drmus0715/trinitybullet/README.md

# プロジェクトEscape「Trinity Bullet」

「TrinityBullet」は、千葉大祭2019で披露された体験型アトラクションです。

詳しい説明は[本リポジトリのWiki](https://github.com/drmus0715/trinitybullet/wiki)を御覧ください。

### Contact

プロジェクトEscape - [pjtescape@gmail.com](mailto:pjtescape@gmail.com)  
Twitter: https://twitter.com/pjtescape  
Youtube: https://www.youtube.com/channel/UCUZIIseGtYRA30toblo56Hg
