drmus0715/trinitybullet/doc/2019 Escプロジェクト「Trinity Bullet」ソフトウェアマニュアル.pdf

# 2019 Project Escape「Trinity Bullet」

# ソフトウェアマニュアル

### 2019/10/29初版 byひろたけ

# 1. 概要

# 「Trinity Bullet」は、主に以下の4つのモジュールで構成されています。

### 1. Panel 2. Master(ESP32) 3. Game Management 4. WebServer

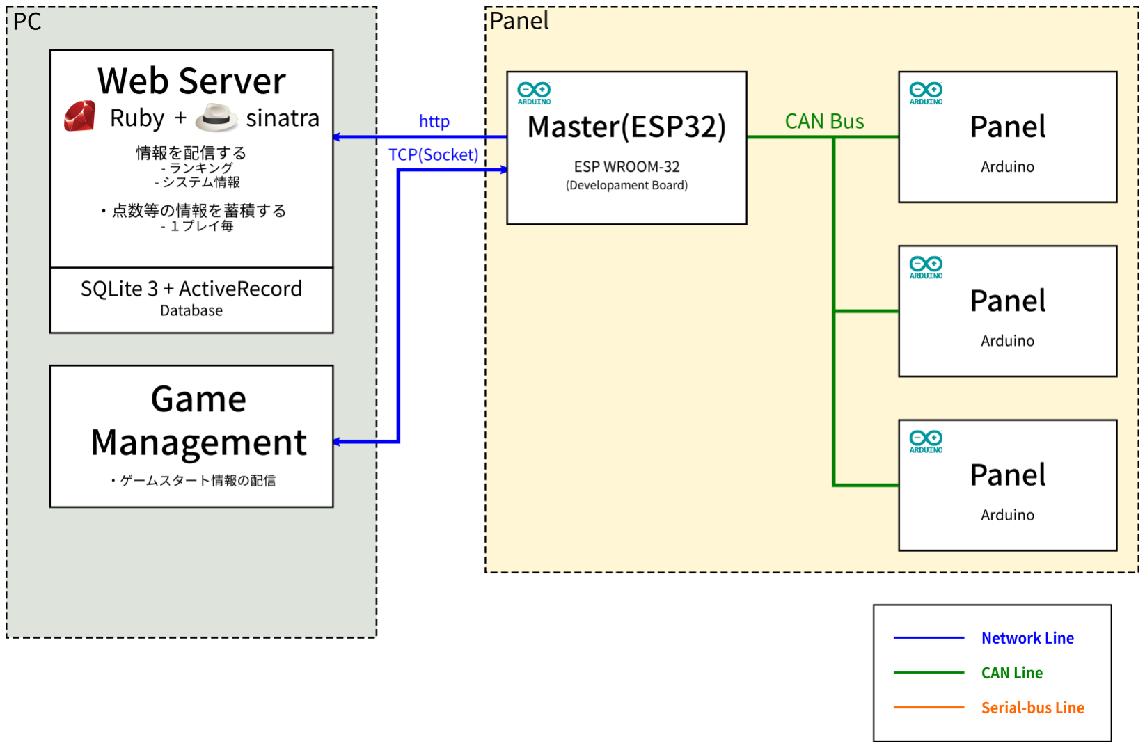
[picture p5: figure]

# また、接続系統は以下の通りです。

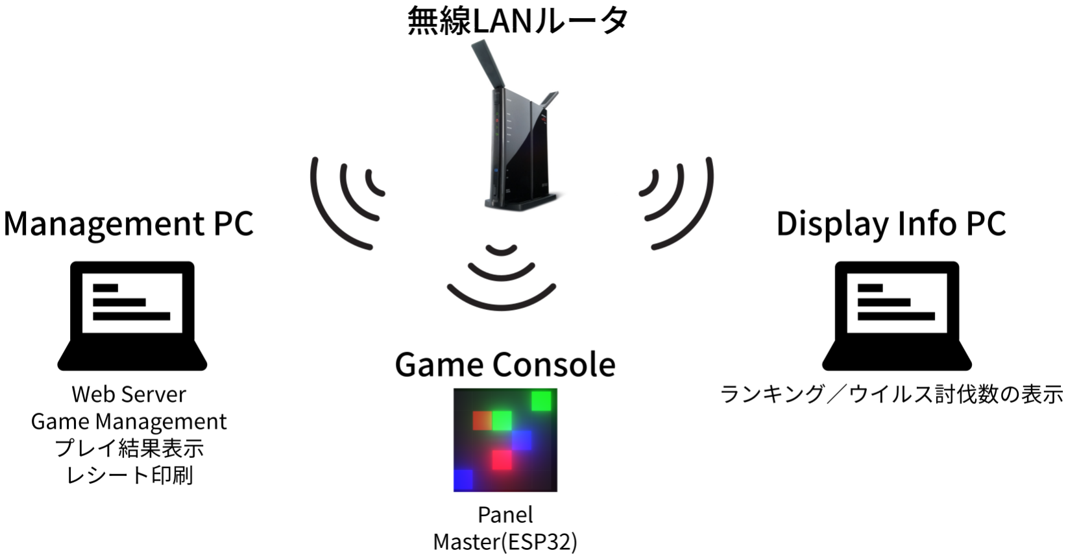
[picture p6: figure]

# 2. 起動⼿順

# ⼤まかに分けて以下の⼿順で起動します。

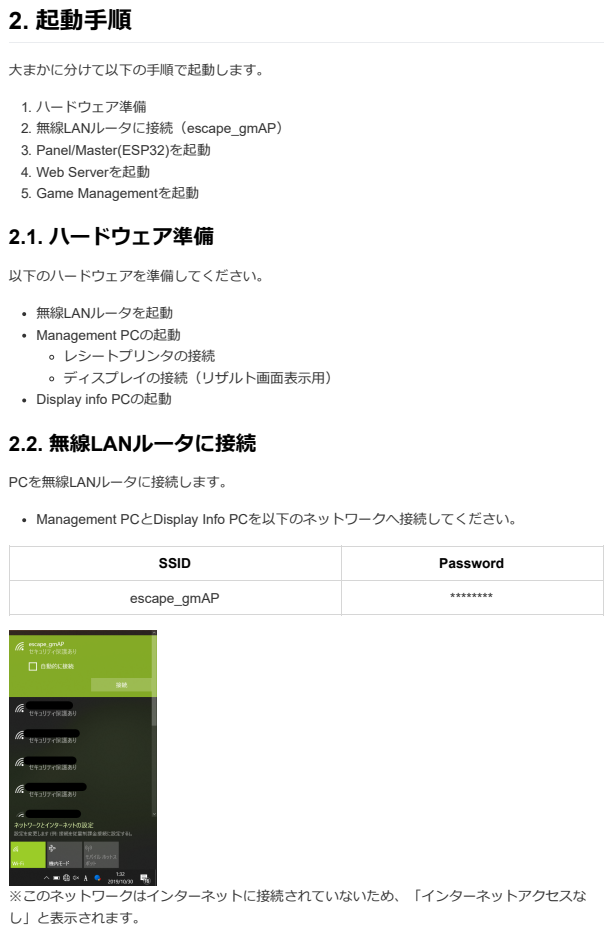
[picture p7: page 3]
PCを無線LANルータに接続します。; ※このネットワークはインターネットに接続されていないため、「インターネットアクセスな し」と表⽰されます。

1. ハードウェア準備
2. 無線LANルータに接続（escape_gmAP）
3. Panel/Master(ESP32)を起動
4. Web Serverを起動
5. Game Managementを起動
2.1. ハードウェア準備

以下のハードウェアを準備してください。
無線LANルータを起動
Management PCの起動
レシートプリンタの接続
ディスプレイの接続（リザルト画⾯表⽰⽤）
Display info PCの起動
2.2. 無線LANルータに接続

Management PCとDisplay Info PCを以下のネットワークへ接続してください。

SSID | Password

escape_gmAP | ********

# 2.3. Panel/Master(ESP32)を起動

# 基板担当に頼むと起動してくれます。

# 2.4. Web Serverを起動

### Web Serverは、Windows PowerShellを⽤いて起動・停⽌操作を⾏います。

# 1. まず、 Windowsキー＋S で検索画⾯を開き、 powershell と打ち込みます。 Enterキー を押して 起動します。

# 2. Web Serverのフォルダに移動します。以下のコマンドをシェル上に打ち込みます。 ※コマンドを打ち込んだら Enterキー で実⾏

cd C:\Users\drmus\Documents\Git\esc-magicbullet\Software\WebServer\docker-sinatra

# 以下のような表⽰になります。

PS C:\Users\drmus> cd C:\Users\drmus\Documents\Git\esc-magicbullet\Software\WebServer\docker-sinatra PS C:\Users\drmus\Documents\Git\esc-magicbullet\Software\WebServer\docker-sinatra>

# 3. docker ps コマンドを実⾏し、WebServerが起動していないことを確認します。

# ※以下のような表⽰のときは既にWebServerが起動しています。⽌める場合

は docker stop [CONTAINER ID] を実⾏します。

PS C:\Users\drmus\Documents\Git\esc-magicbullet\Software\WebServer\docker-sinatra> docker ps
CONTAINER ID | IMAGE | COMMAND | CREATED | STATUS | PORTS
PS C:\Users\drmus\Documents\Git\esc-magicbullet\Software\WebServer\docker-sinatra>

### 4. WebServerを起動します。

# 以下のコマンドを実⾏して、WebServerを起動します。

docker run -p 4567:4567 docker-sinatra

# 以下のような表⽰になったら起動成功です。

# ※以下のような表⽰になっていた場合、既にWebserverが起動しています。

### 5. Web Server終了⽅法

# WebServerが起動している状態から Ctrl+C を押下することで操作できるようになります。 以下のコマンドでWebServerをストップします。

docker stop $(docker ps -q)

## 2.4.1. 例外

# DBをリセットするとき DBをコピー→起動しているやつをストップ→コンテナを削除→再ビルド このあとは⼿順4.に移動します。

docker cp [CONTAINER ID]:/app/db/main.db ../db_backup/[NEW DB NAME].db docker stop $(docker ps -q)
docker container prune
docker build -t docker-sinatra .

# 2.5. Game Managementを起動

### PythonコンソールからGame Managementを起動します。

# 1. デスクトップ上の以下のアイコンをクリックし、Pythonコンソールを起動します。

PS C:\Users\drmus\Documents\Git\esc-magicbullet\Software\WebServer\docker-sinatra> docker ps
CONTAINER ID | IMAGE | COMMAND | CREATED | STATUS | PO
c517610d1da0 | docker-sinatra | "bundle exec ruby ap…" | 34 seconds ago | Up 32 seconds | 0.0
PS C:\Users\drmus\Documents\Git\esc-magicbullet\Software\WebServer\docker-sinatra> docker stop c517610d1da0 c517610d1da0
PS C:\Users\drmus\Documents\Git\esc-magicbullet\Software\WebServer\docker-sinatra>

PS C:\Users\drmus\Documents\Git\esc-magicbullet\Software\WebServer\docker-sinatra> docker run -p 4567:4567 d == Sinatra (v1.4.8) has taken the stage on 4567 for development with backup from Thin

PS C:\Users\drmus\Documents\Git\esc-magicbullet\Software\WebServer\docker-sinatra> docker run -p 4567:4567 d C:\Program Files\Docker\Docker\Resources\bin\docker.exe: Error response from daemon: driver failed programm PS C:\Users\drmus\Documents\Git\esc-magicbullet\Software\WebServer\docker-sinatra>

# 2. Game Managementのフォルダに移動します。以下のコマンドをシェル上に打ち込みます。 ※コマンドを打ち込んだら Enterキー で実⾏

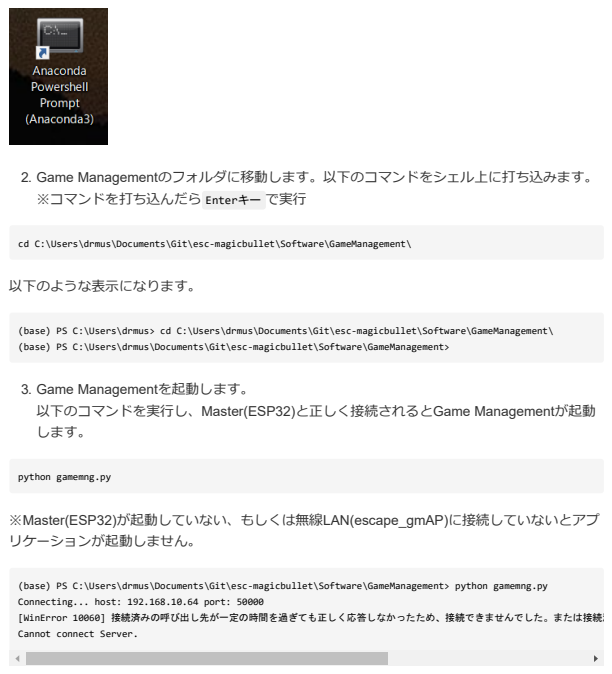
[picture p8: page 6]
以下のような表⽰になります。

cd C:\Users\drmus\Documents\Git\esc-magicbullet\Software\GameManagement\

(base) PS C:\Users\drmus> cd C:\Users\drmus\Documents\Git\esc-magicbullet\Software\GameManagement\
(base) PS C:\Users\drmus\Documents\Git\esc-magicbullet\Software\GameManagement>

3. Game Managementを起動します。
以下のコマンドを実⾏し、Master(ESP32)と正しく接続されるとGame Managementが起動
します。

python gamemng.py

※Master(ESP32)が起動していない、もしくは無線LAN(escape_gmAP)に接続していないとアプ
リケーションが起動しません。

(base) PS C:\Users\drmus\Documents\Git\esc-magicbullet\Software\GameManagement> python gamemng.py
Connecting... host: 192.168.10.64 port: 50000
[WinError 10060] 接続済みの呼び出し先が一定の時間を過ぎても正しく応答しなかったため、接続できませんでした。または接続済
Cannot connect Server.

# 3. ゲームの流れ

# ゲームプレイ時は以下の流れで進みます。

### 1. Game Managementへプレイヤー情報を打ち込む 2. Game Management「PlayerEntry」を押し、ゲーム開始

# 1. (プレイヤー)中⼼のパネルを踏みプレイ開始 2. (プレイヤー)受付へ 3. レシートを印刷

# 3.1. Game Management 操作説明

# 3.2. レシート印刷⽅法

# 4. トラブルシューティング
