drmus0715/trinitybullet/Software/WebServer/Design/index.html

Trinity Bullet Result Gateway

結果 ランキング ウイルス討伐数 (no redi.)ランキング (no redi.)ウイルス討伐数 レシート印刷 DB Debug
