drmus0715/trinitybullet/doc/img/display.JPG

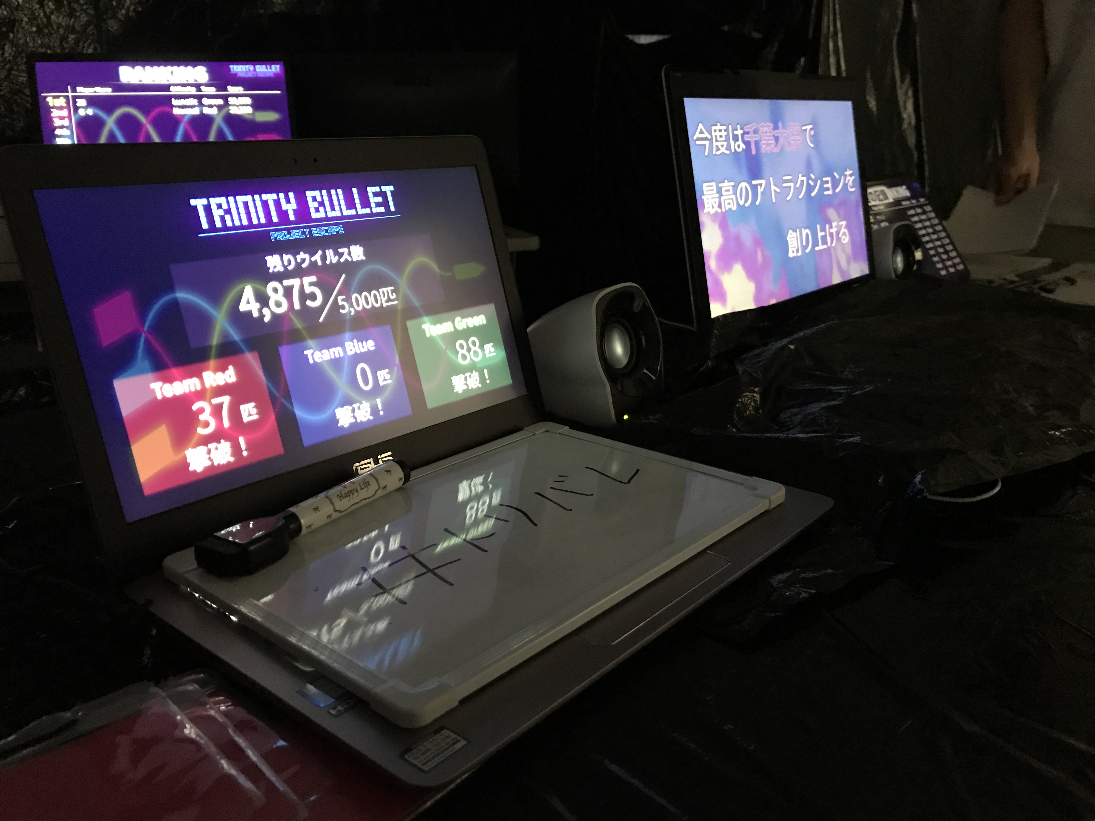
doc/img/display.JPG
