drmus0715/trinitybullet/Hardware/ハードウェア構成図.png

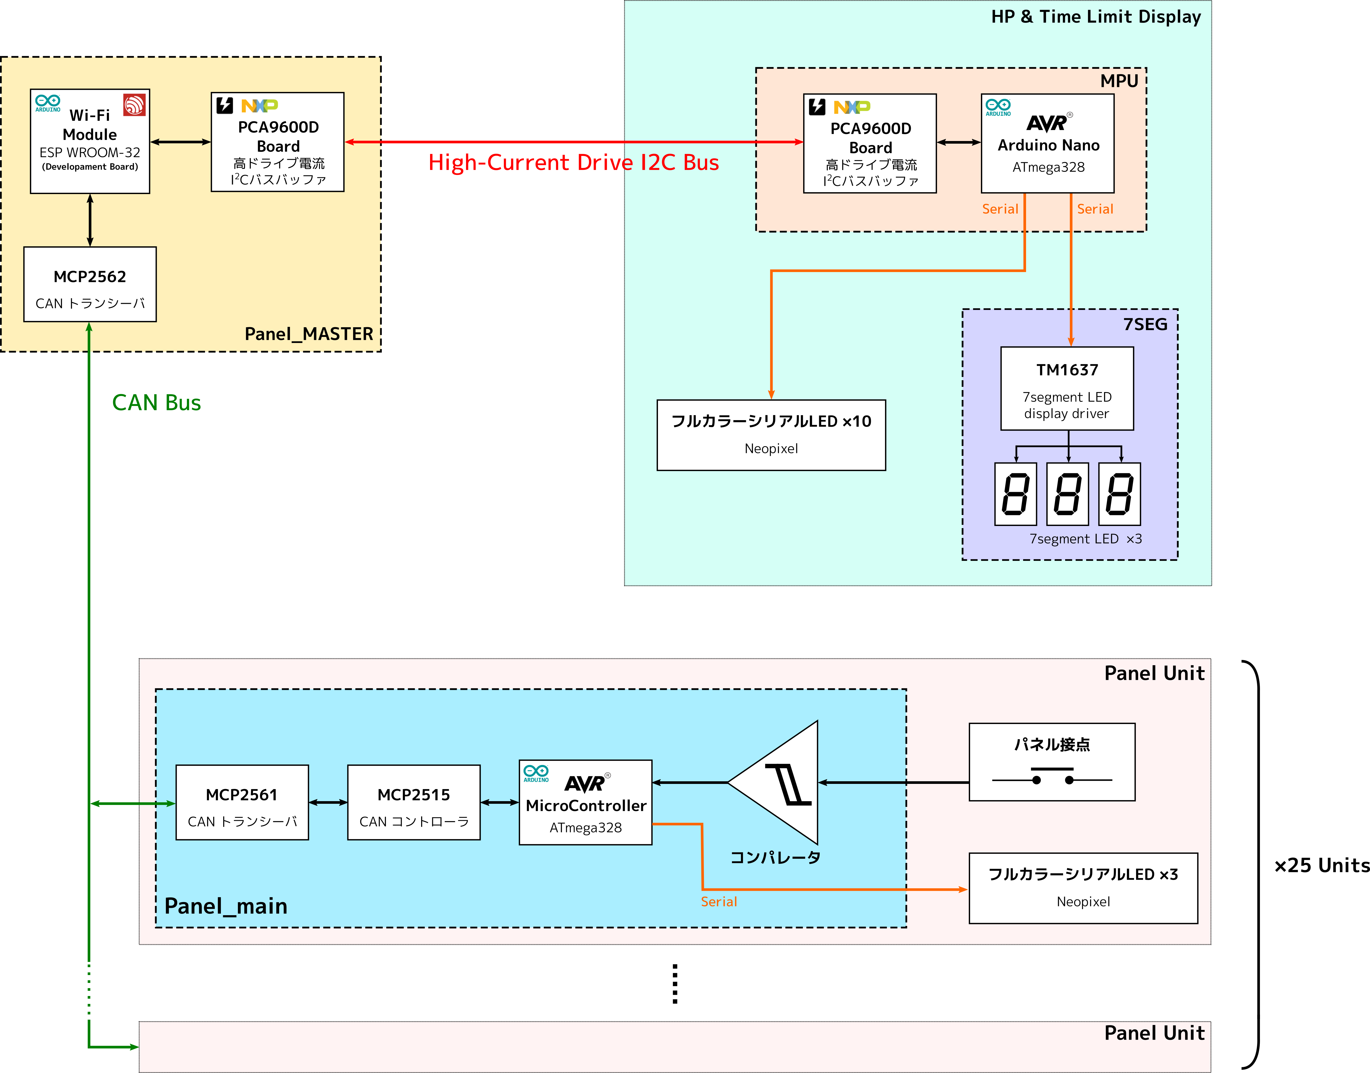
Hardware/ハードウェア構成図.png
