drmus0715/trinitybullet/Hardware/仕様書/img/5VPB.PNG

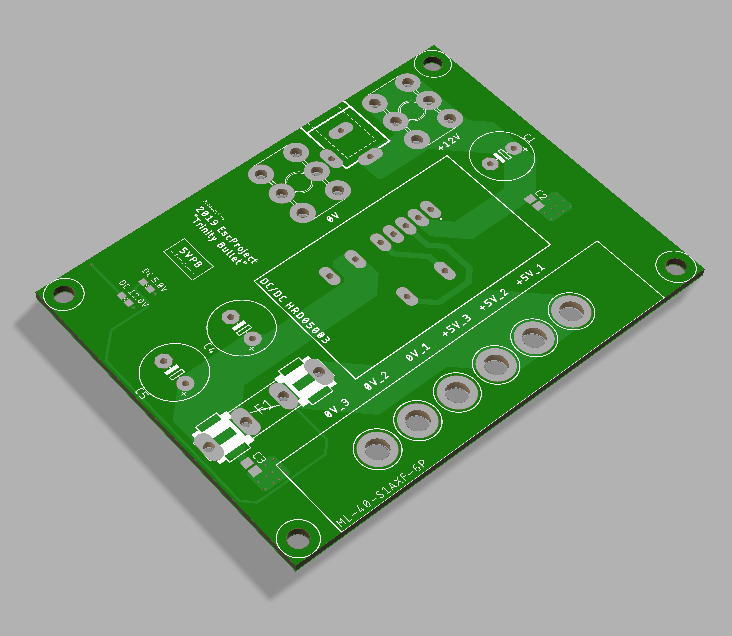
Hardware/仕様書/img/5VPB.PNG
