drmus0715/trinitybullet/Hardware/仕様書/img/b3psvha.jpg

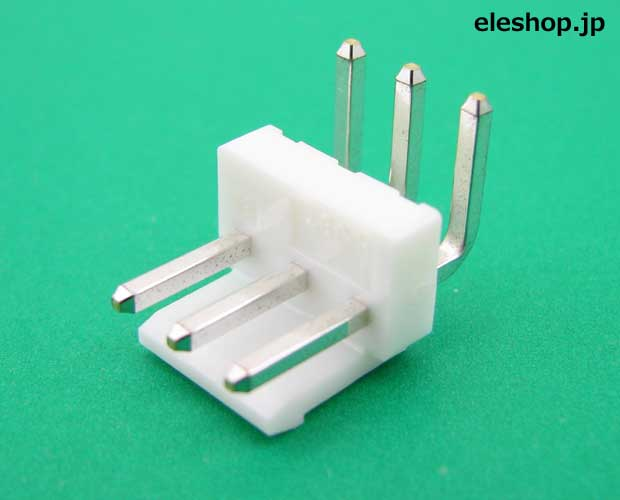
Hardware/仕様書/img/b3psvha.jpg
