drmus0715/trinitybullet/Hardware/仕様書/img/C-12812.jpg

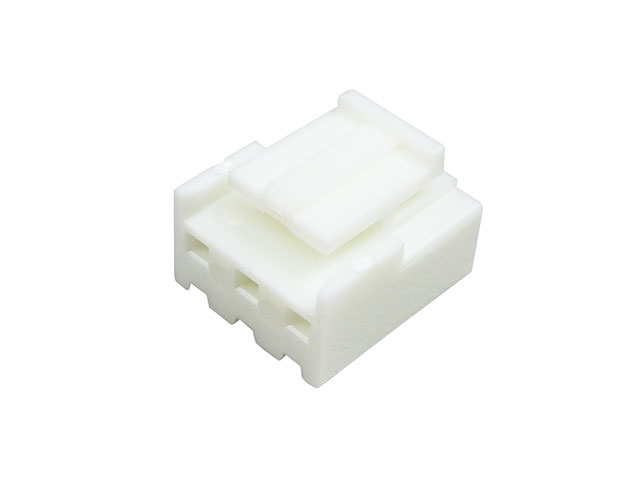
Hardware/仕様書/img/C-12812.jpg
