drmus0715/trinitybullet/Hardware/仕様書/img/Panel_main.png

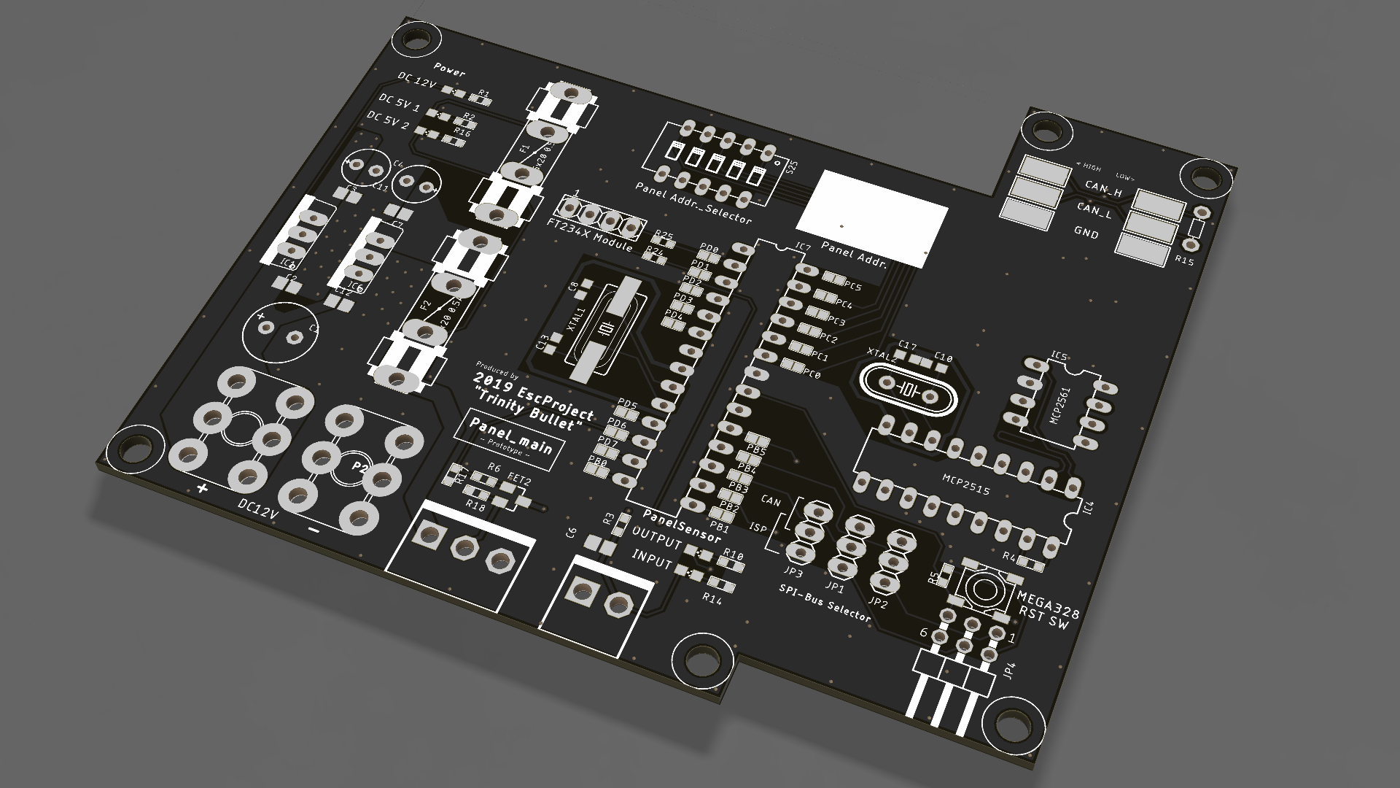
Hardware/仕様書/img/Panel_main.png
