drmus0715/trinitybullet/Hardware/仕様書/img/Panel_main寸法.PNG

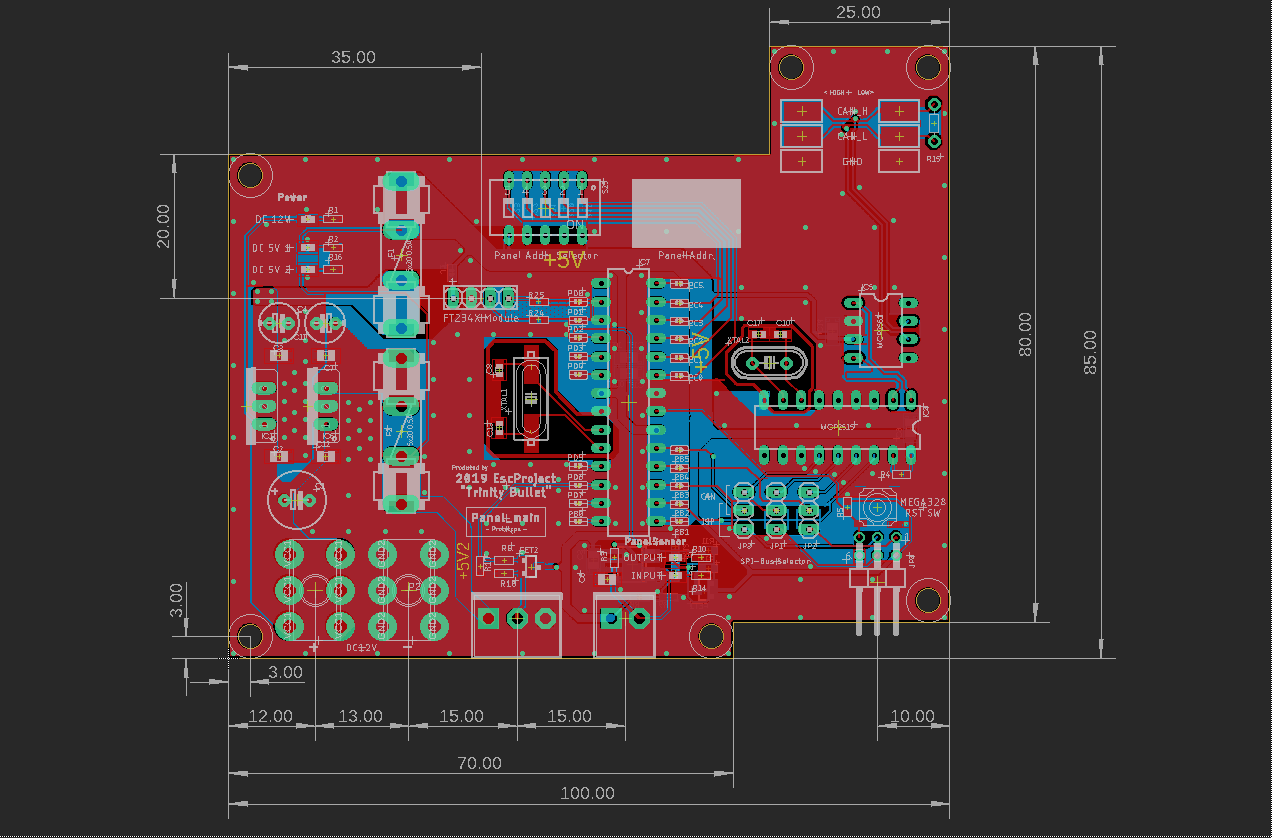
Hardware/仕様書/img/Panel_main寸法.PNG
