drmus0715/trinitybullet/Ranking/day1_info.png

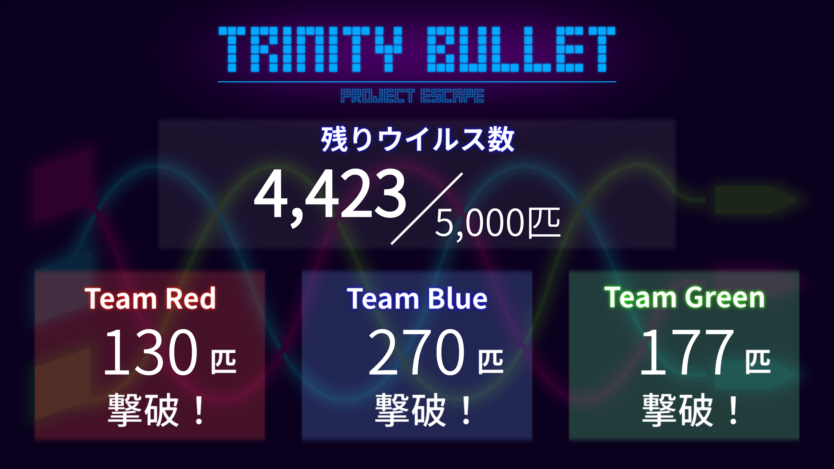
Ranking/day1_info.png
