drmus0715/trinitybullet/Ranking/day1_ranking_cut.png

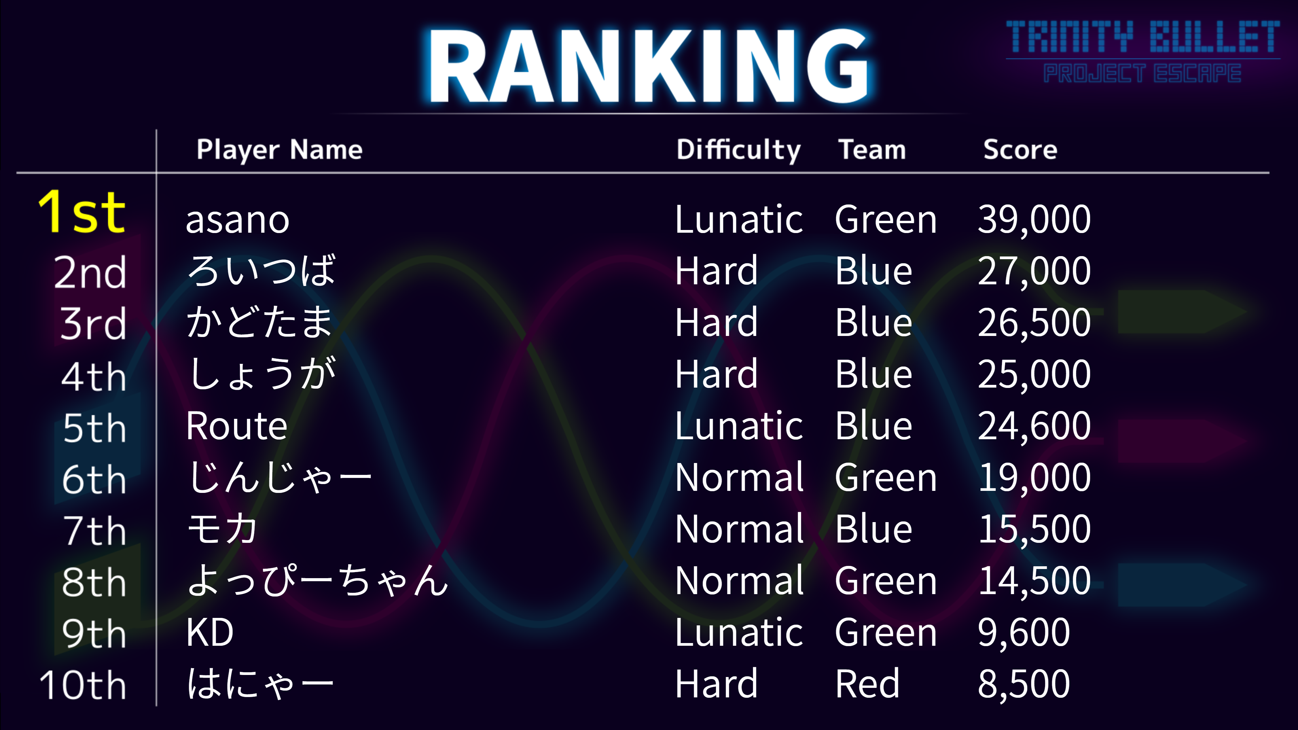
Ranking/day1_ranking_cut.png
