drmus0715/trinitybullet/Ranking/day3_info.png

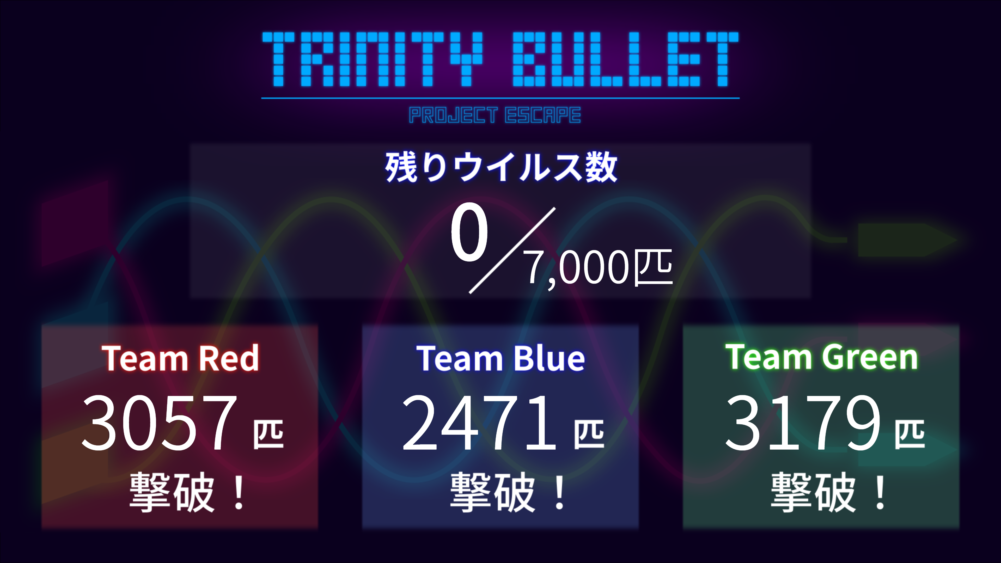
Ranking/day3_info.png
