drmus0715/trinitybullet/Ranking/day3_ranking.png

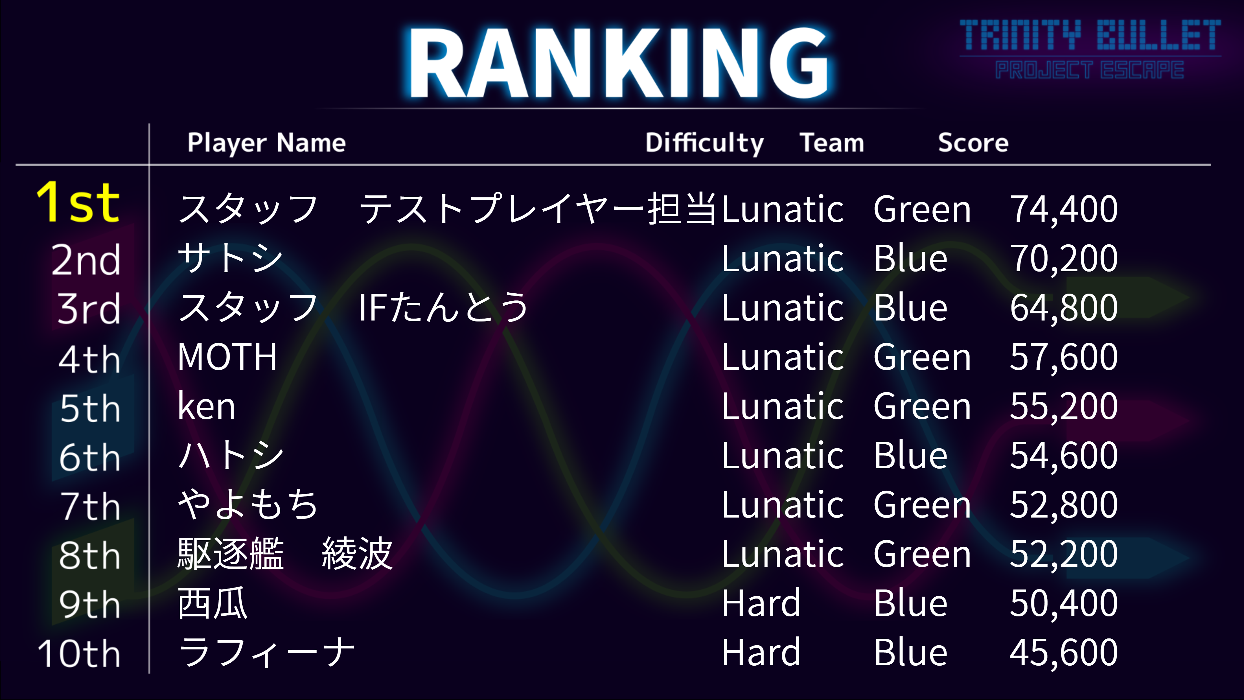
Ranking/day3_ranking.png
