drmus0715/trinitybullet/Ranking/day4_ranking.png

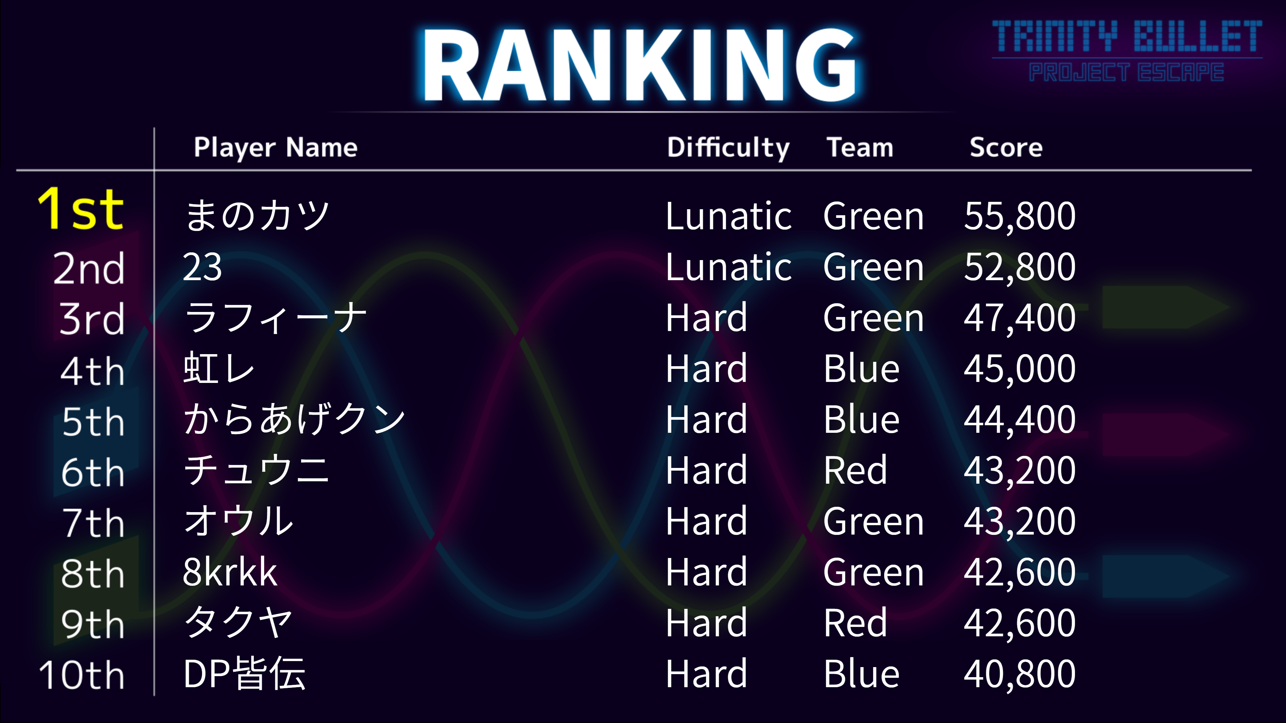
Ranking/day4_ranking.png
