drmus0715/trinitybullet/Ranking/gateway.png

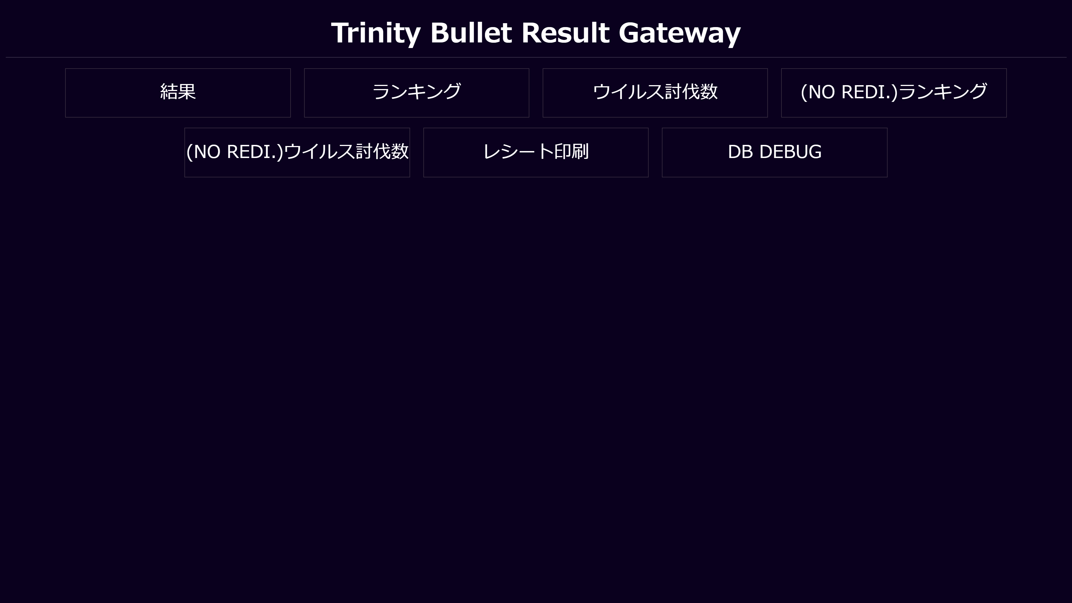
Ranking/gateway.png
