drmus0715/trinitybullet/Software/WebServer/Design/20191022_外観イメージ3.png

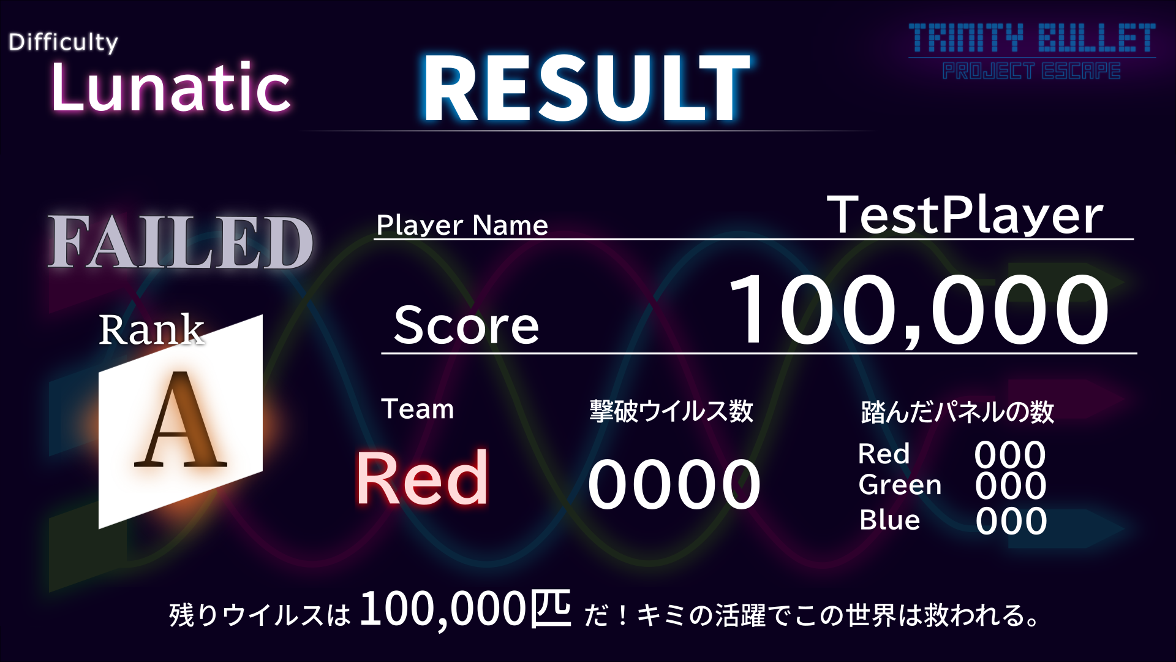
Software/WebServer/Design/20191022_外観イメージ3.png
