drmus0715/trinitybullet/Software/WebServer/Design/rank/rank_a.png

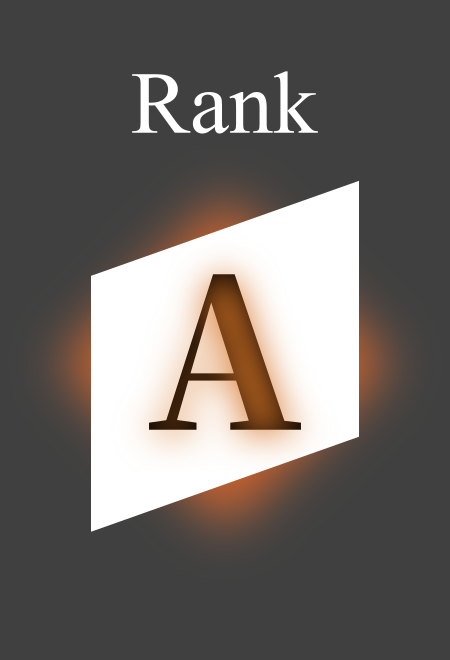
Software/WebServer/Design/rank/rank_a.png
