drmus0715/trinitybullet/Software/WebServer/Design/rank/rank_b.png

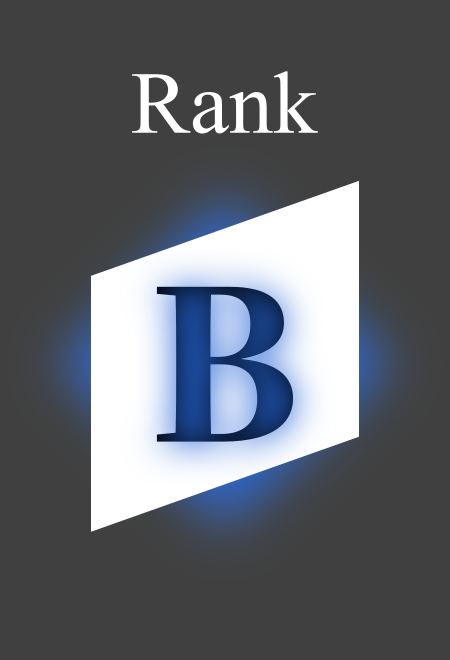
Software/WebServer/Design/rank/rank_b.png
