drmus0715/trinitybullet/Software/WebServer/Design/レシート/receipt.png

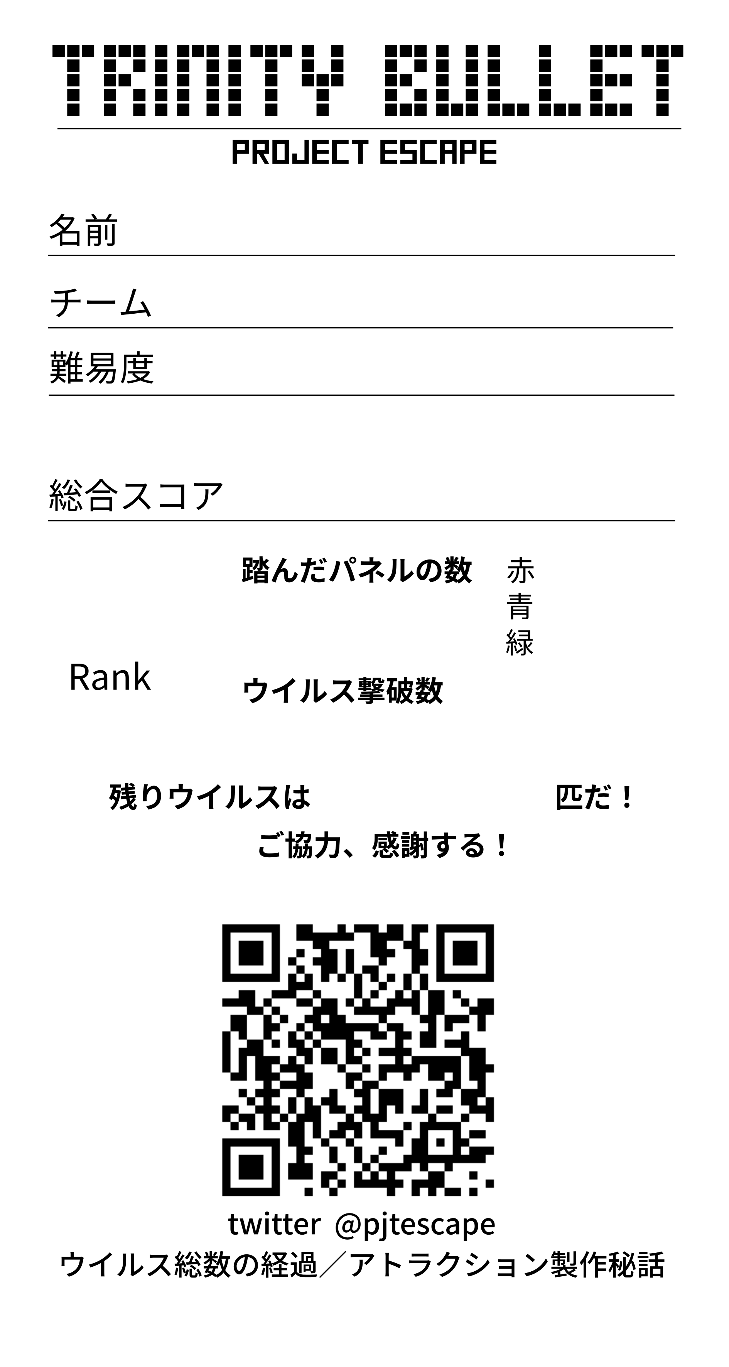
Software/WebServer/Design/レシート/receipt.png
