drmus0715/trinitybullet/Hardware/Schematic/Panel_main_public.pdf

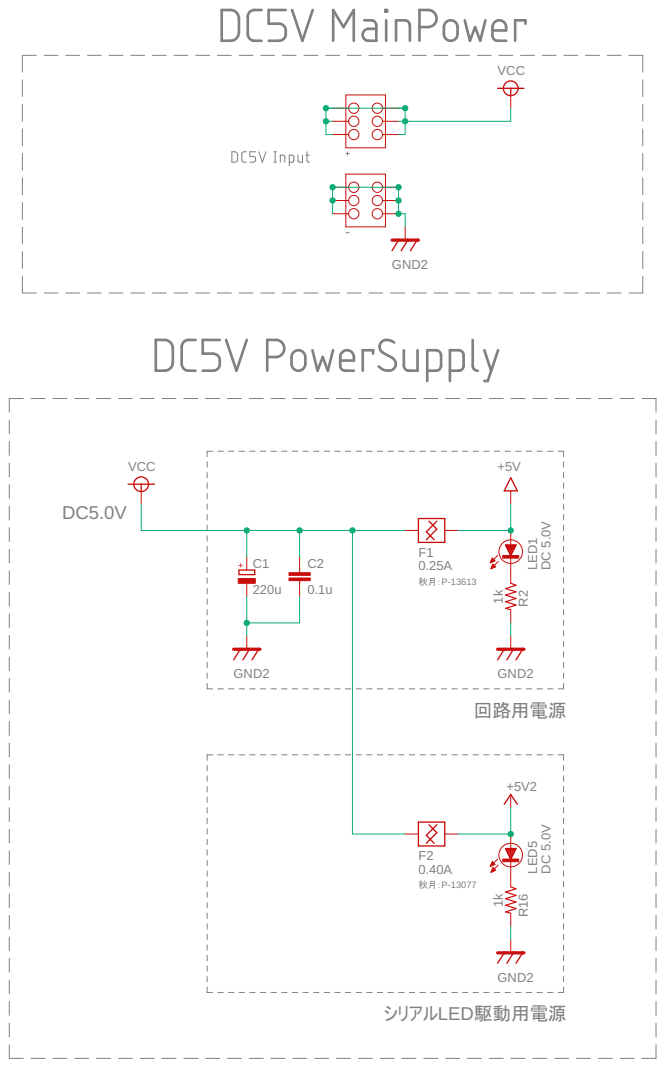
[picture p44: page 1]

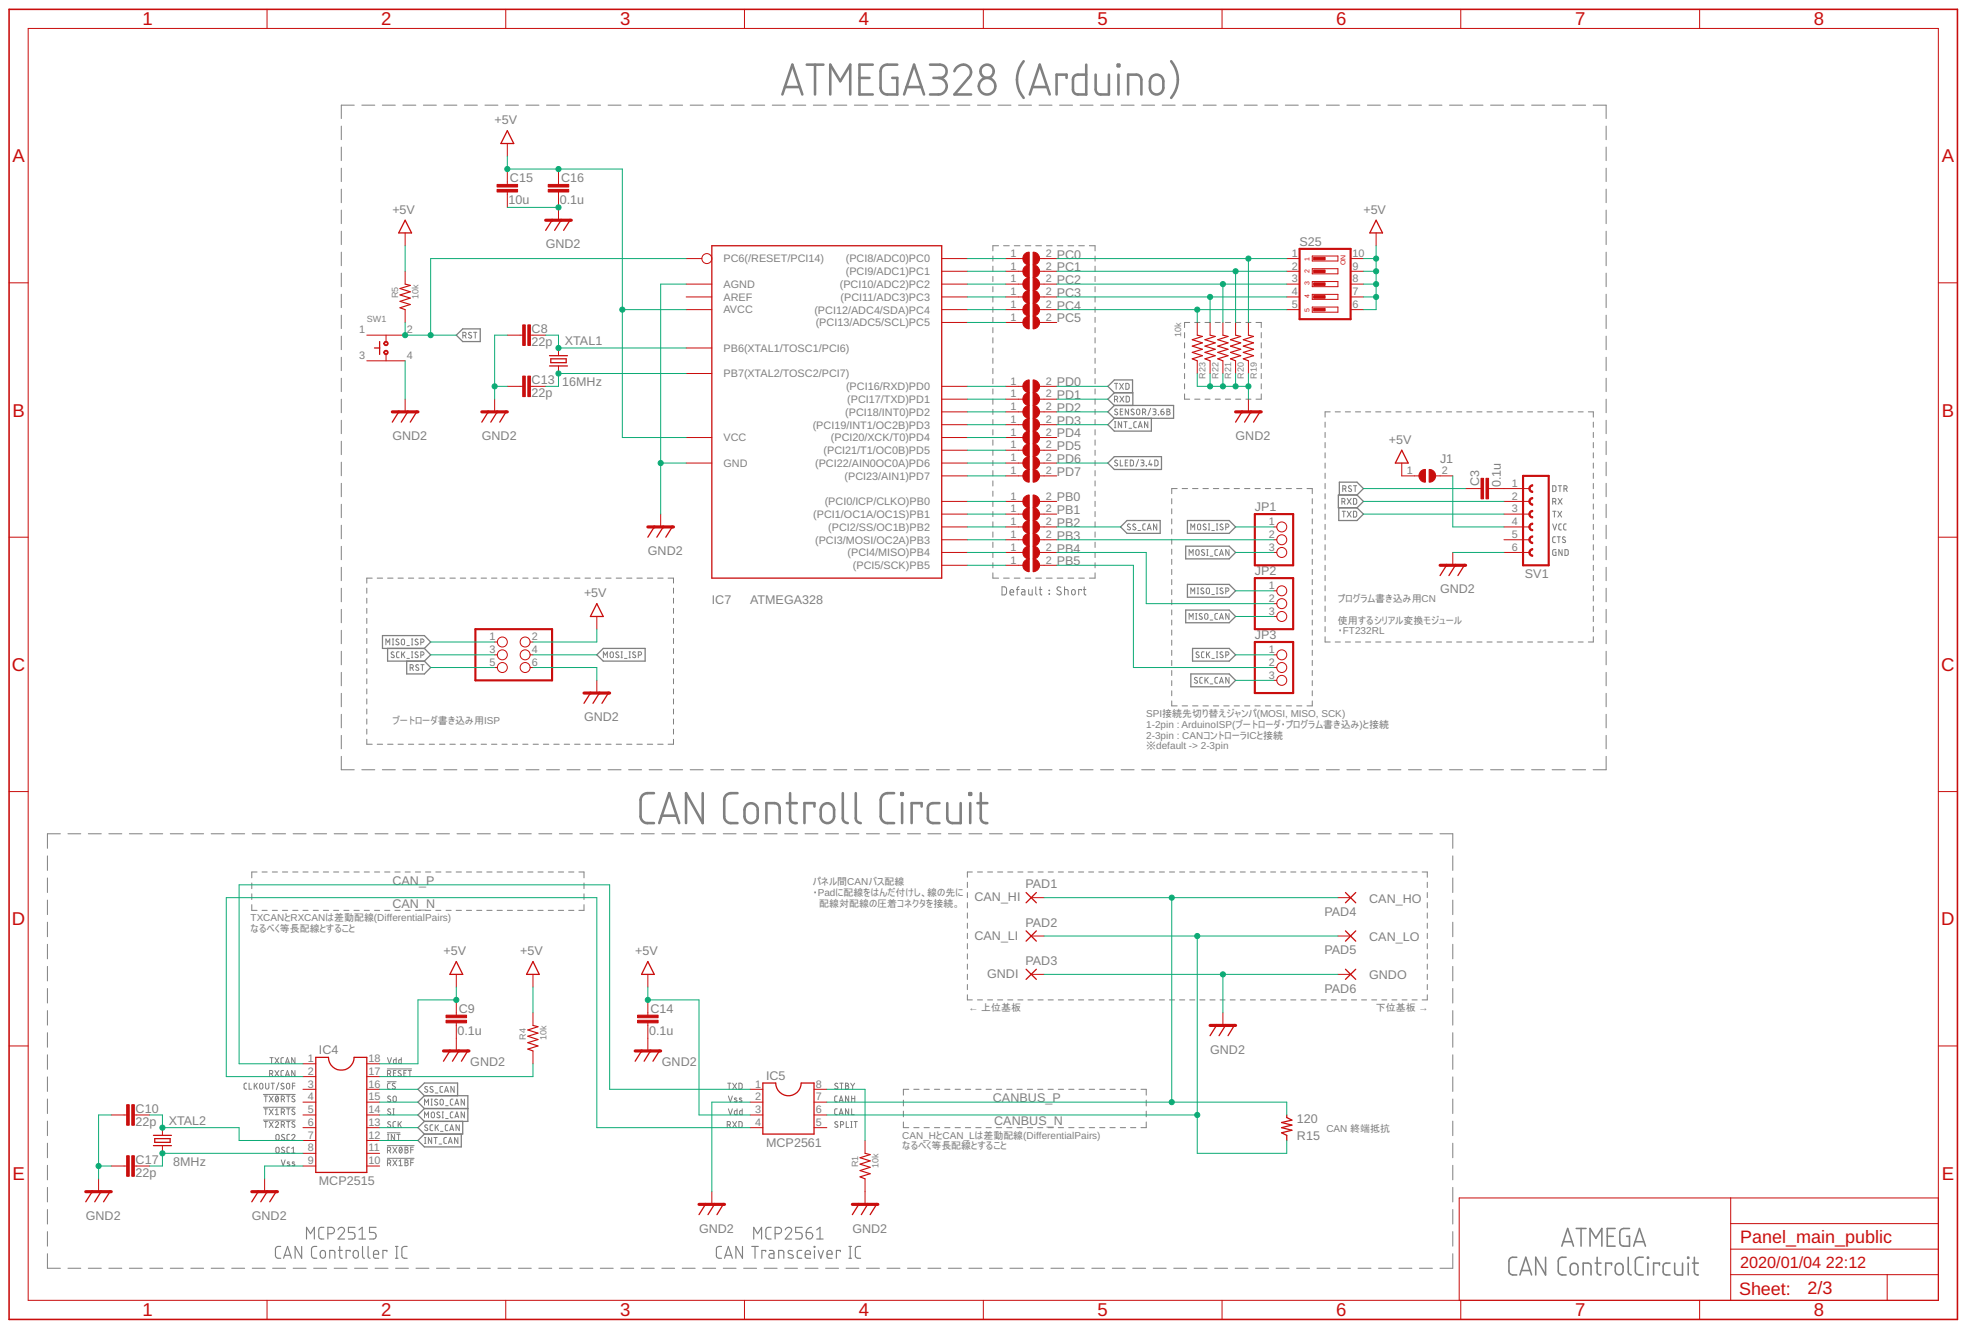
[picture p45: page 2]

SPI接続先切り替えジャンパ(MOSI, MISO, SCK) 1-2pin : ArduinoISP(ブートローダ・プログラム書き込み)と接続

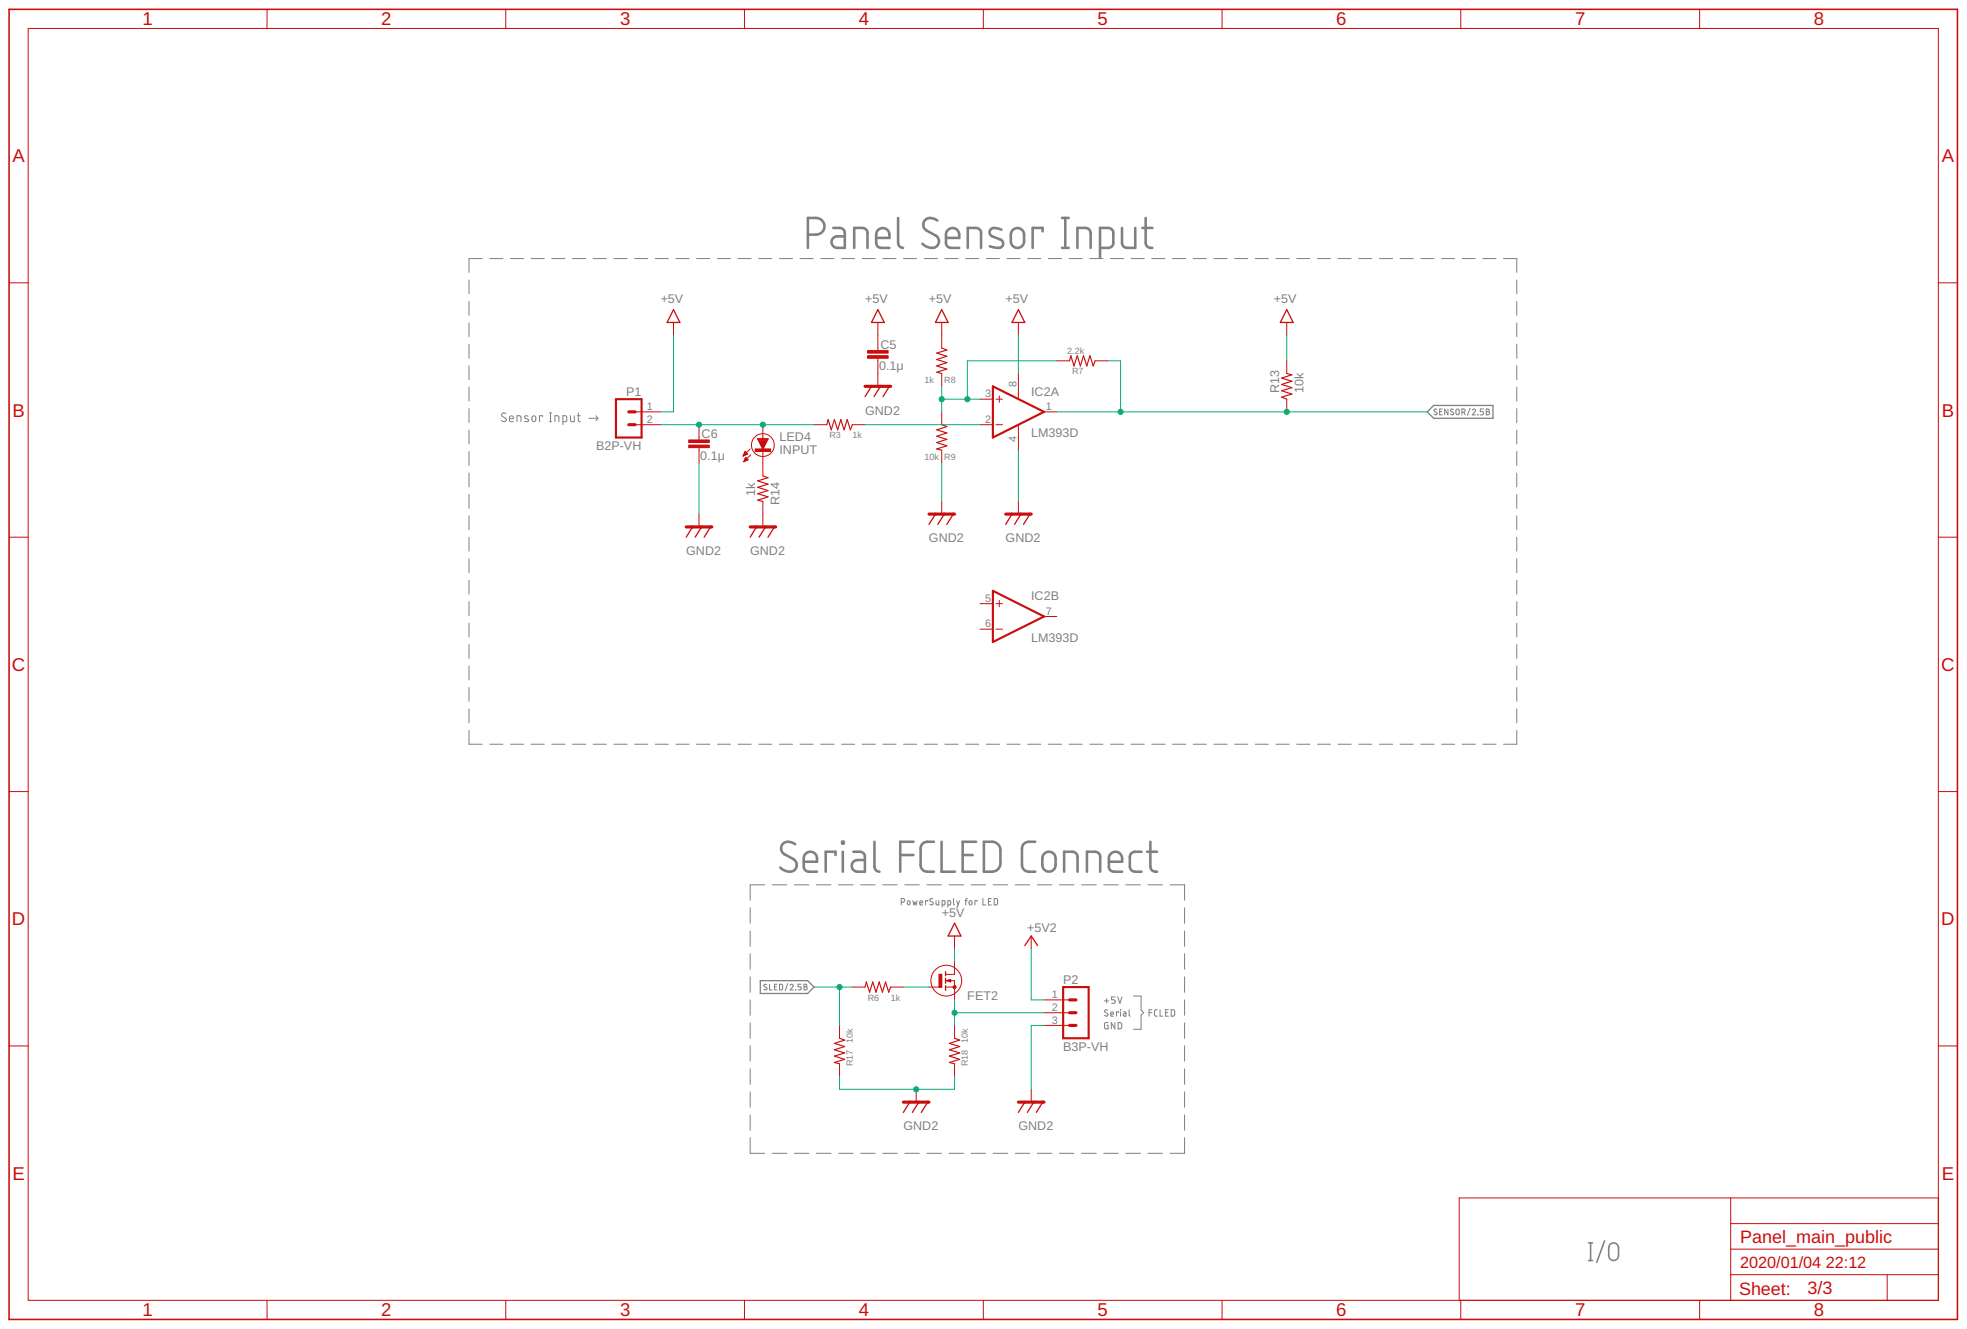
[picture p46: page 3]
