drmus0715/trinitybullet/Hardware/Schematic/Panel_Master_public.pdf

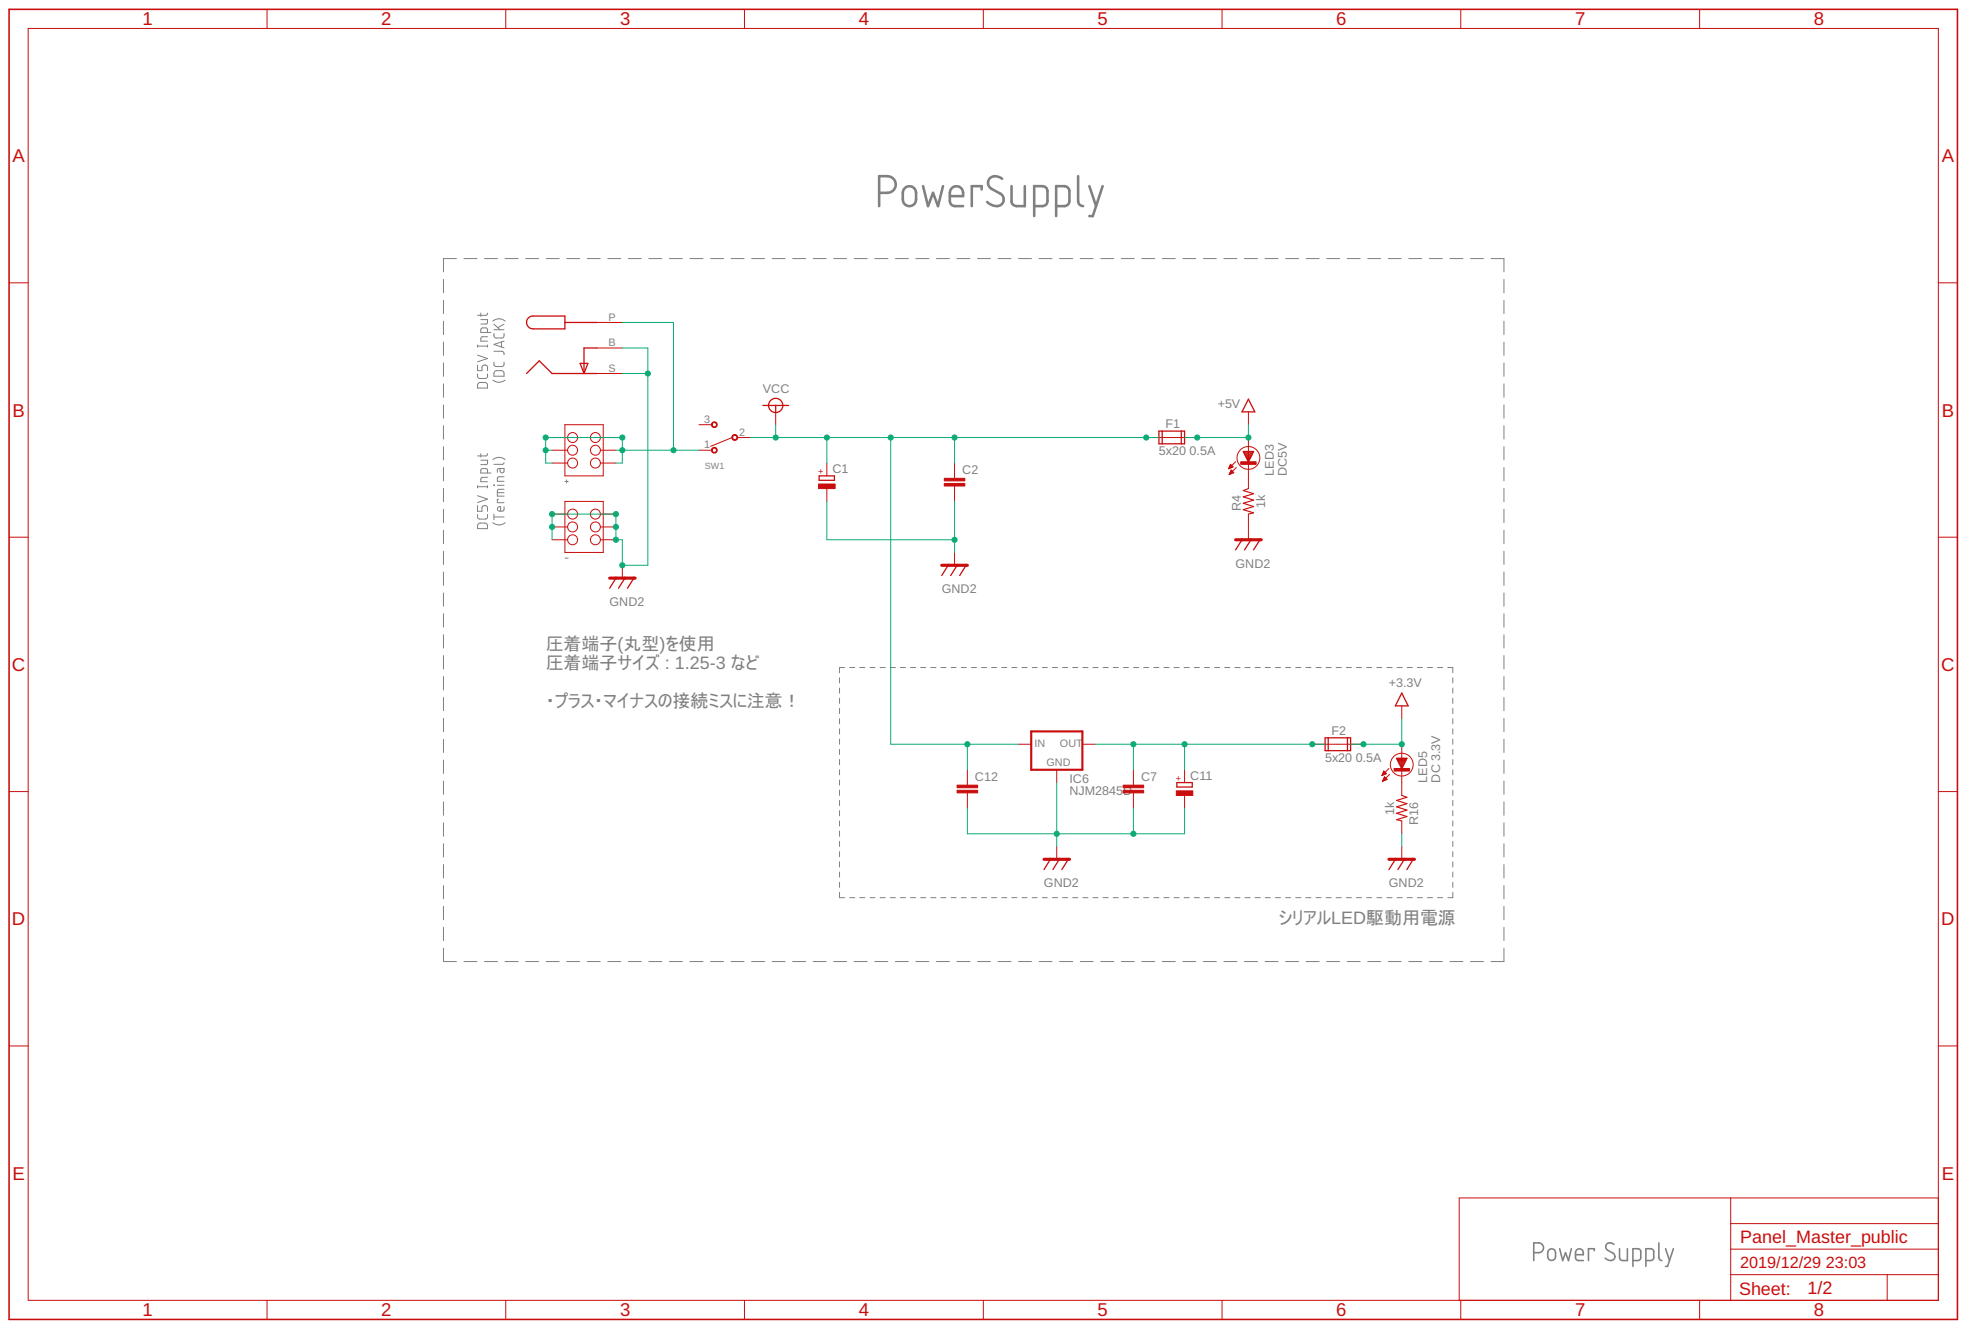
[picture p47: page 1]

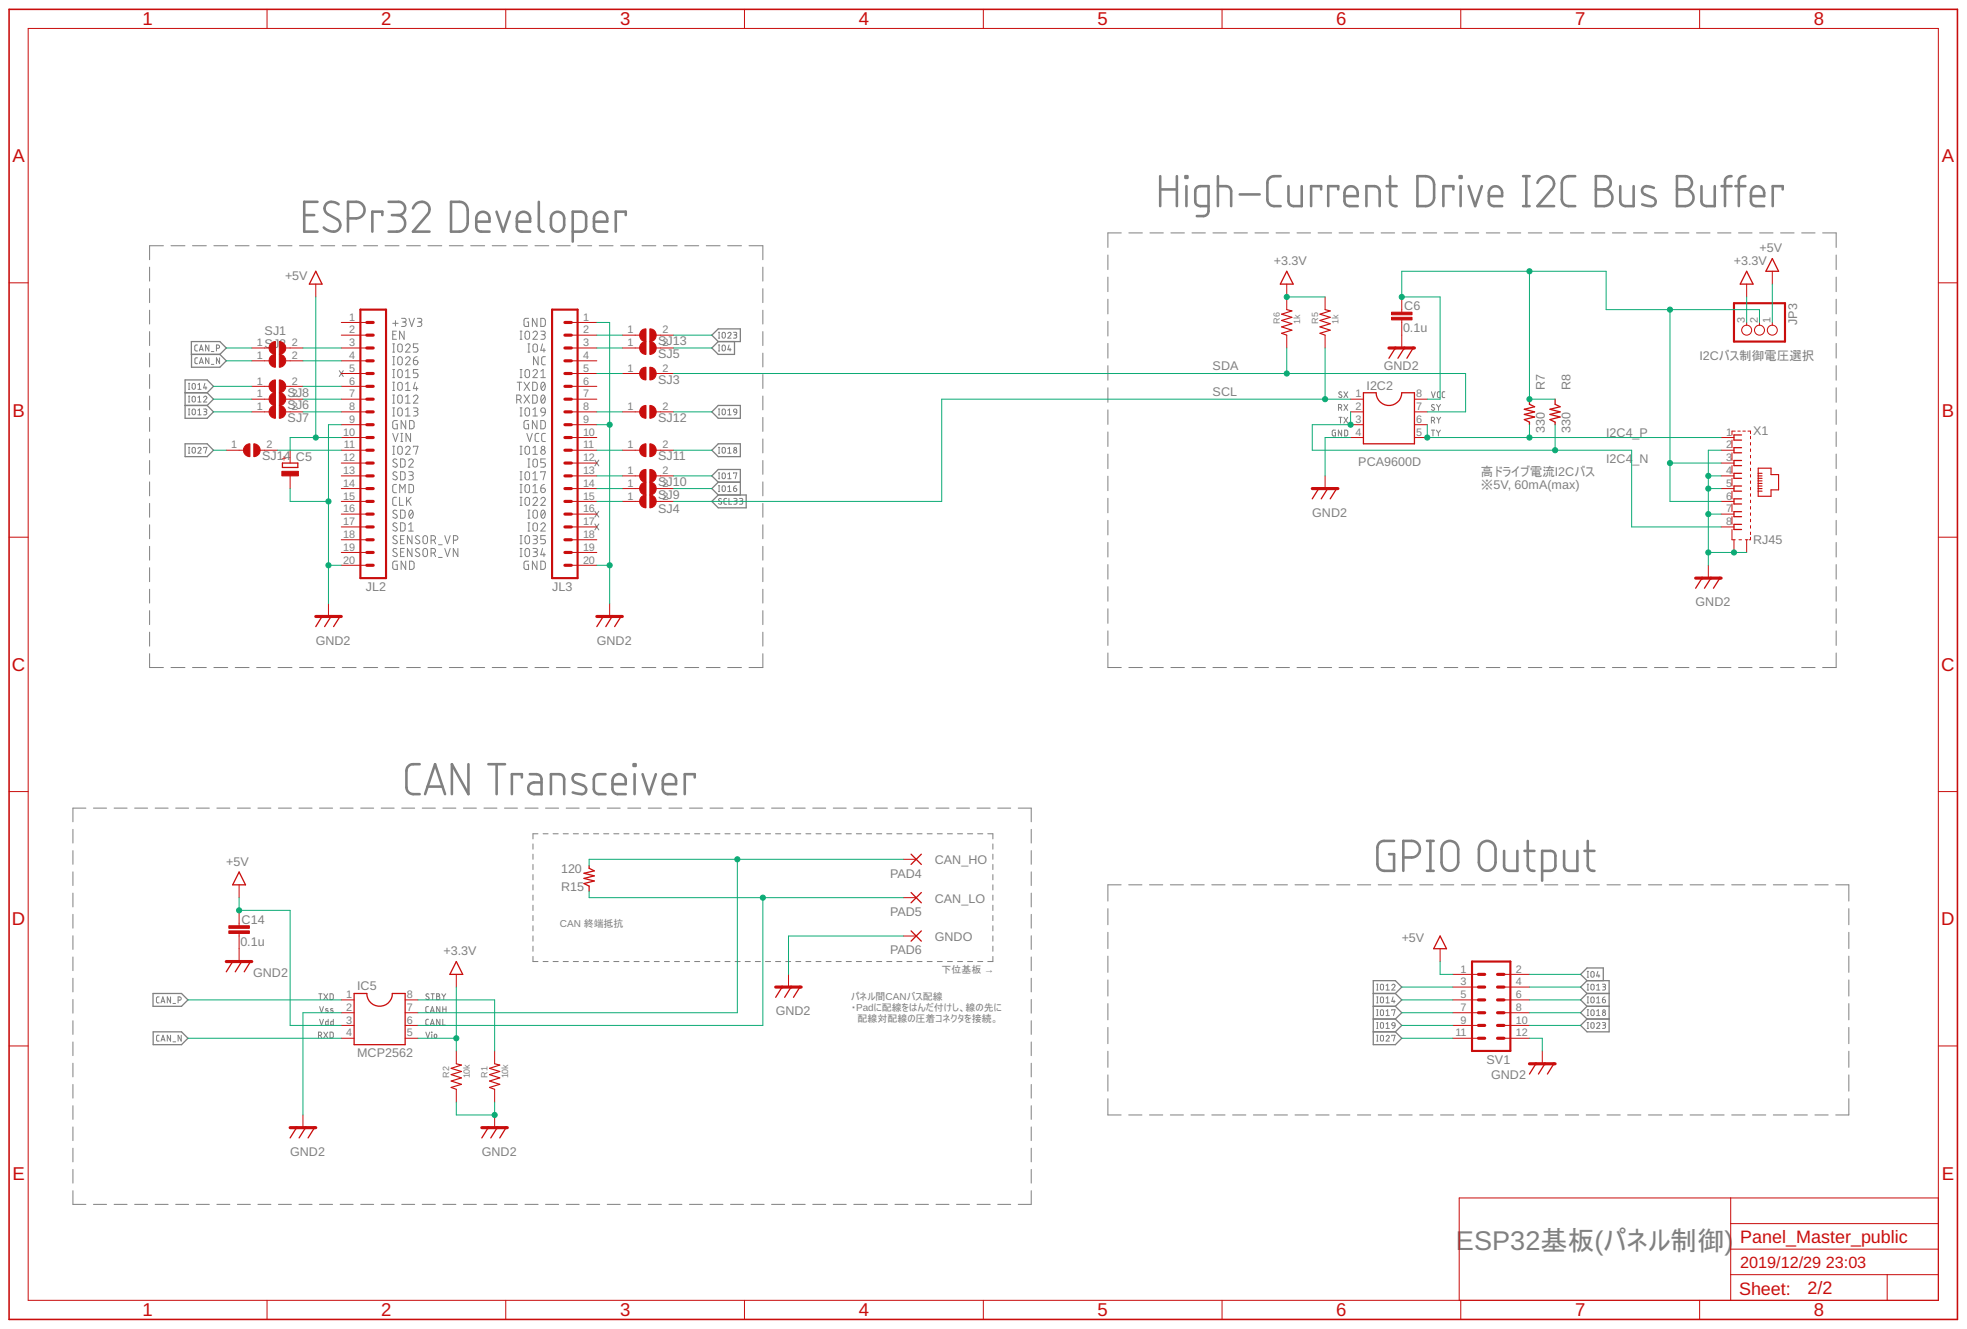
[picture p48: page 2]

・Padに配線をはんだ付けし、線の先に 配線対配線の圧着コネクタを接続。 下位基板 →

ESP32基板(パネル制御)

Sheet: 2/2
