drmus0715/trinitybullet/doc/2019 Escプロジェクト「Trinity Bullet」ソフトウェア概要設計書.pdf

## 2019 Esc「Trinity Bullet」

# ソフトウェア概要設計書

2019年6⽉9⽇初版 byひろたけ
以降随時更新

## 1. 概要

本⽂書では、2019年度Escプロジェクト「Trinity Bullet」のシステム全体の構成や、各モジュールの 役割、モジュール間の通信⽅式を定める。つまるところ⽂書にまとめないと忘れるよねってことで す。

# 2. システム構成

こんな感じのシステムを予定しています・・・たいへんそ・・・

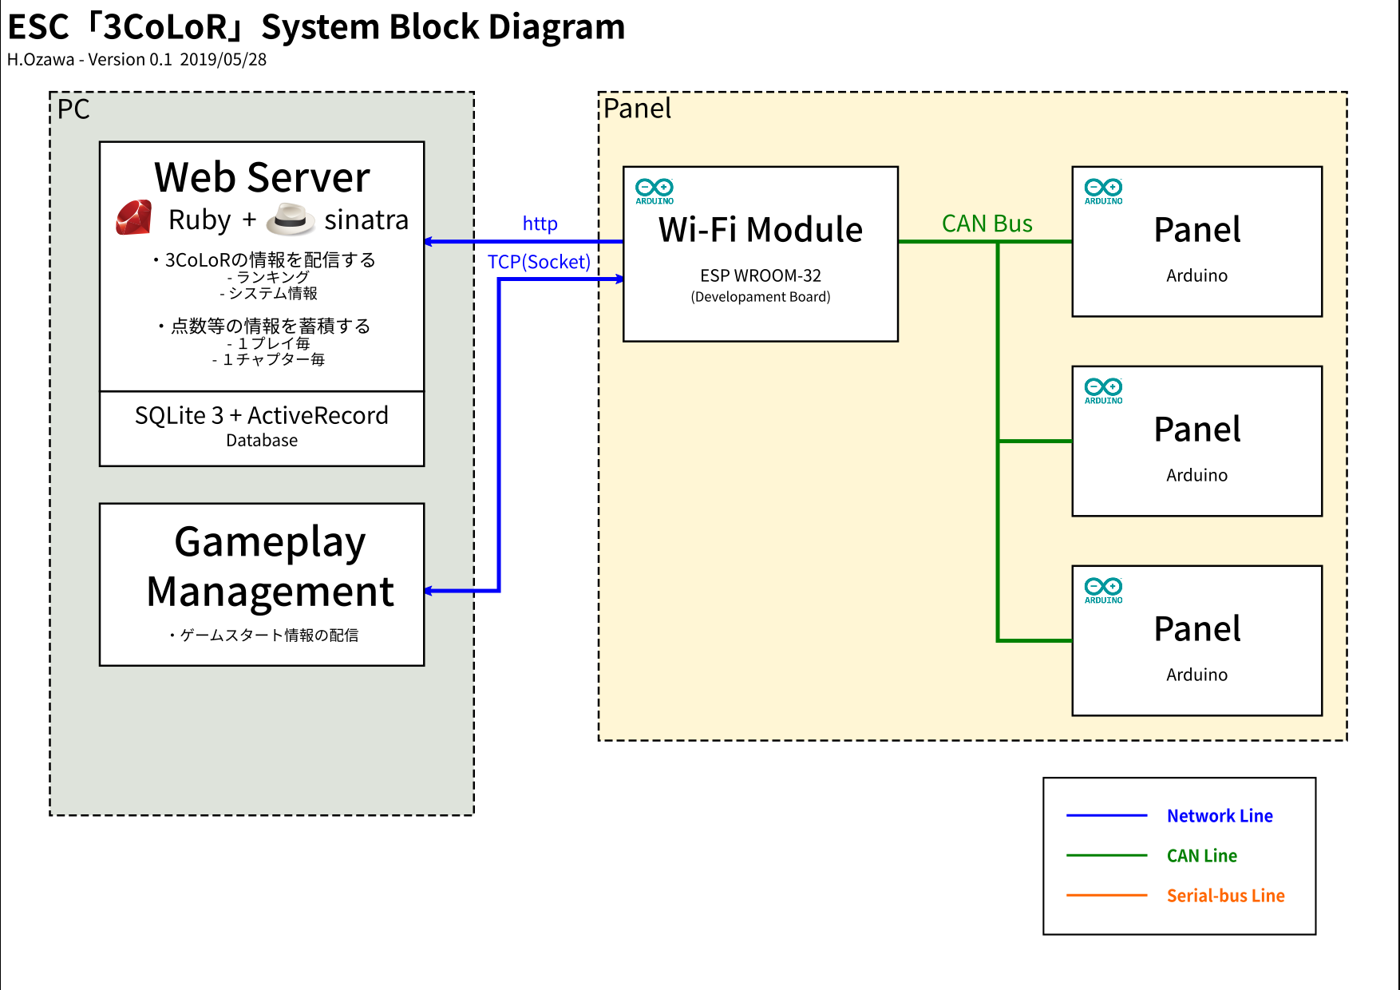
[picture p49: figure]

# 3. 各モジュールについて

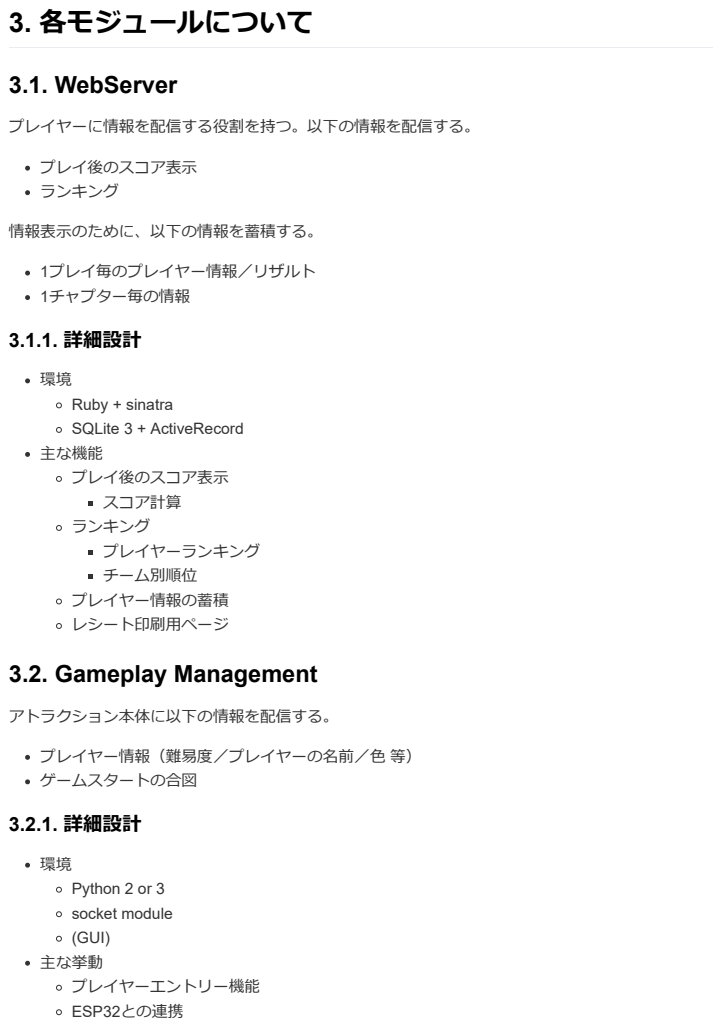
[picture p50: page 2]
3.1. WebServer; プレイヤーに情報を配信する役割を持つ。以下の情報を配信する。; プレイ後のスコア表⽰ ランキング; 情報表⽰のために、以下の情報を蓄積する。; 1プレイ毎のプレイヤー情報／リザルト 1チャプター毎の情報; 3.1.1. 詳細設計; Ruby + sinatra SQLite 3 + ActiveRecord 主な機能 プレイ後のスコア表⽰ スコア計算 ランキング プレイヤーランキング チーム別順位 プレイヤー情報の蓄積 レシート印刷⽤ページ; 3.2. Gameplay Management; アトラクション本体に以下の情報を配信する。; プレイヤー情報（難易度／プレイヤーの名前／⾊ 等） ゲームスタートの合図; 3.2.1. 詳細設計; Python 2 or 3 socket module (GUI) 主な挙動 プレイヤーエントリー機能 ESP32との連携

### 3.3. WiFi Module - ESP32

PCから⾒たClientで、Panelから⾒たMasterの役割。主にPanelの管理とServerとの通信に使う。持
つ機能は以下の通り。

### 3.3.1. 詳細設計

主な挙動
⾮ゲーム開始時のデモ点灯機能
Gameplay Mngとの連携
ゲームプレイ中
制限時間タイマ
外部デバイスへの出⼒
ランダム⾊選択機能
ゲームの難易度付け
押されたボタンの集計
体⼒カウント機能
外部デバイスへの出⼒
⾳声再⽣機能
ゲーム終了時のWebアップロード機能（REST Client） タスク・キュー・セマフォ
デバイス系タスク
TimeDisplayMng
time Send Queue
役割︓時間表⽰ディスプレイを管理する。キューを受信したら⼀秒ごとに時間情 報を送信する。
※時間情報を持つのはメイン︖このタスク︖
HpGaugeMng
hp Send Queue
役割︓HP表⽰ディスプレイを管理する。キューを受信したらその情報に従ってHP を表⽰する。
CAN_receive
CAN_semphr
役割︓CANから情報を受信する。受信した情報はメインタスクに送信する。
CAN_Transmit
CAN_semphr
役割︓CANを送信する。パネル押下許可命令／LED点灯命令 コントロール系タスク
controlMain
役割︓ゲームシーケンスの実⾏

### 3.4. Panel

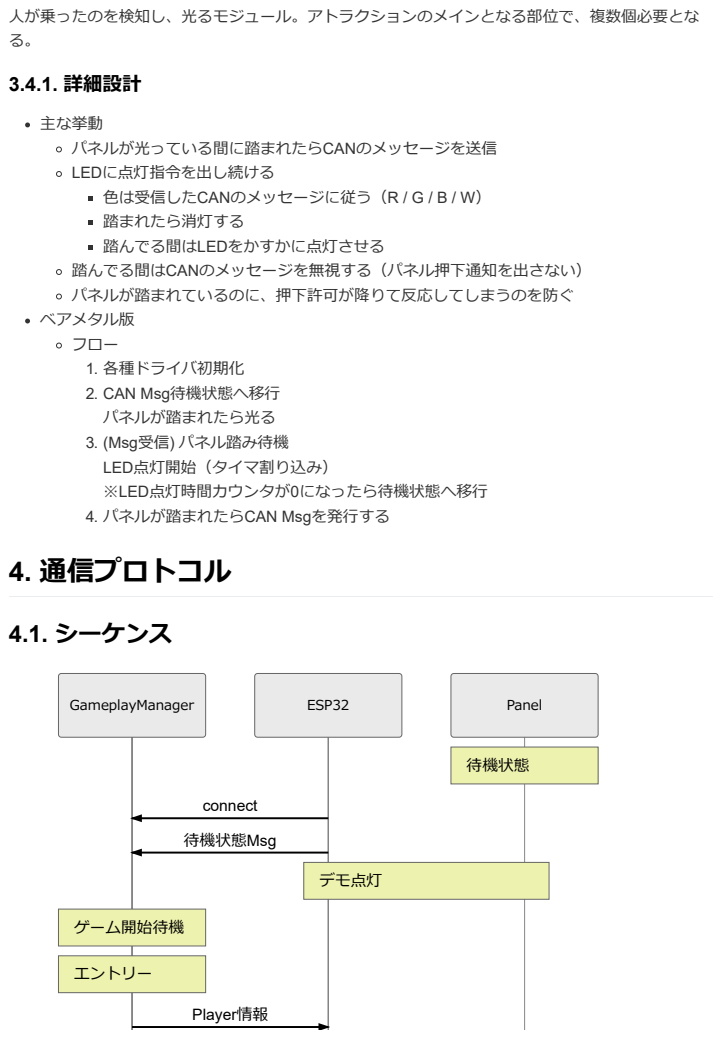
[picture p51: page 4]
⼈が乗ったのを検知し、光るモジュール。アトラクションのメインとなる部位で、複数個必要とな る。; 3.4.1. 詳細設計; 主な挙動 パネルが光っている間に踏まれたらCANのメッセージを送信 LEDに点灯指令を出し続ける ⾊は受信したCANのメッセージに従う（R / G / B / W） 踏まれたら消灯する 踏んでる間はLEDをかすかに点灯させる 踏んでる間はCANのメッセージを無視する（パネル押下通知を出さない） パネルが踏まれているのに、押下許可が降りて反応してしまうのを防ぐ ベアメタル版 フロー 1. 各種ドライバ初期化 2. CAN Msg待機状態へ移⾏ パネルが踏まれたら光る 3. (Msg受信) パネル踏み待機 LED点灯開始（タイマ割り込み） ※LED点灯時間カウンタが0になったら待機状態へ移⾏ 4. パネルが踏まれたらCAN Msgを発⾏する 4. 通信プロトコル; 4.1. シーケンス; GameplayManager; ESP32; Panel; 待機状態; connect 待機状態Msg; デモ点灯; ゲーム開始待機; エントリー; Player情報

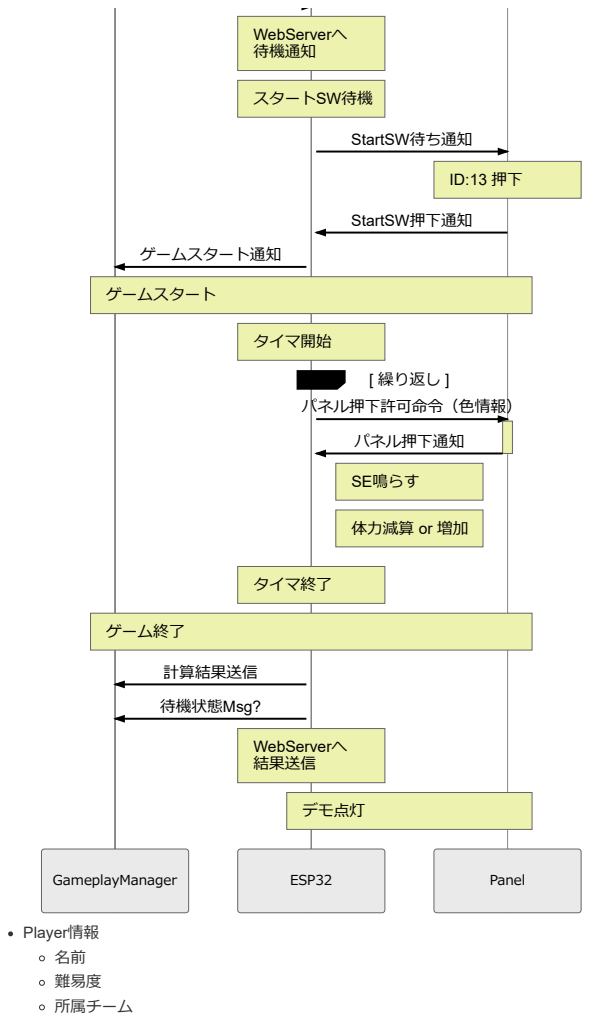
[picture p52: page 5]
WebServerへ 待機通知; スタートSW待機; StartSW待ち通知; StartSW押下通知; ゲームスタート通知; ゲームスタート; タイマ開始; パネル押下許可命令（⾊情報） パネル押下通知; SE鳴らす; loop; [ 繰り返し ]; タイマ終了; ゲーム終了; 計算結果送信 待機状態Msg?; WebServerへ 結果送信; デモ点灯; GameplayManager; ESP32; Panel; Player情報 名前 難易度 所属チーム

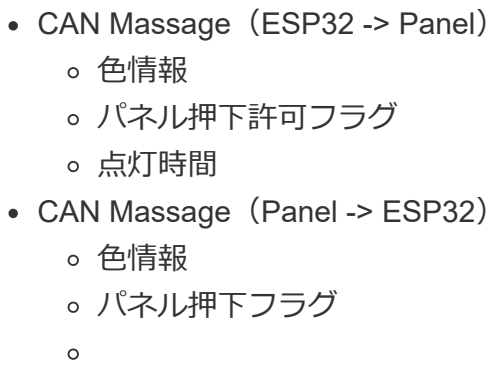
[picture p53: figure]
CAN Massage（ESP32 -> Panel） ⾊情報 パネル押下許可フラグ 点灯時間 CAN Massage（Panel -> ESP32） ⾊情報 パネル押下フラグ
