drmus0715/trinitybullet/Hardware/Schematic/PowerConsole_public.pdf

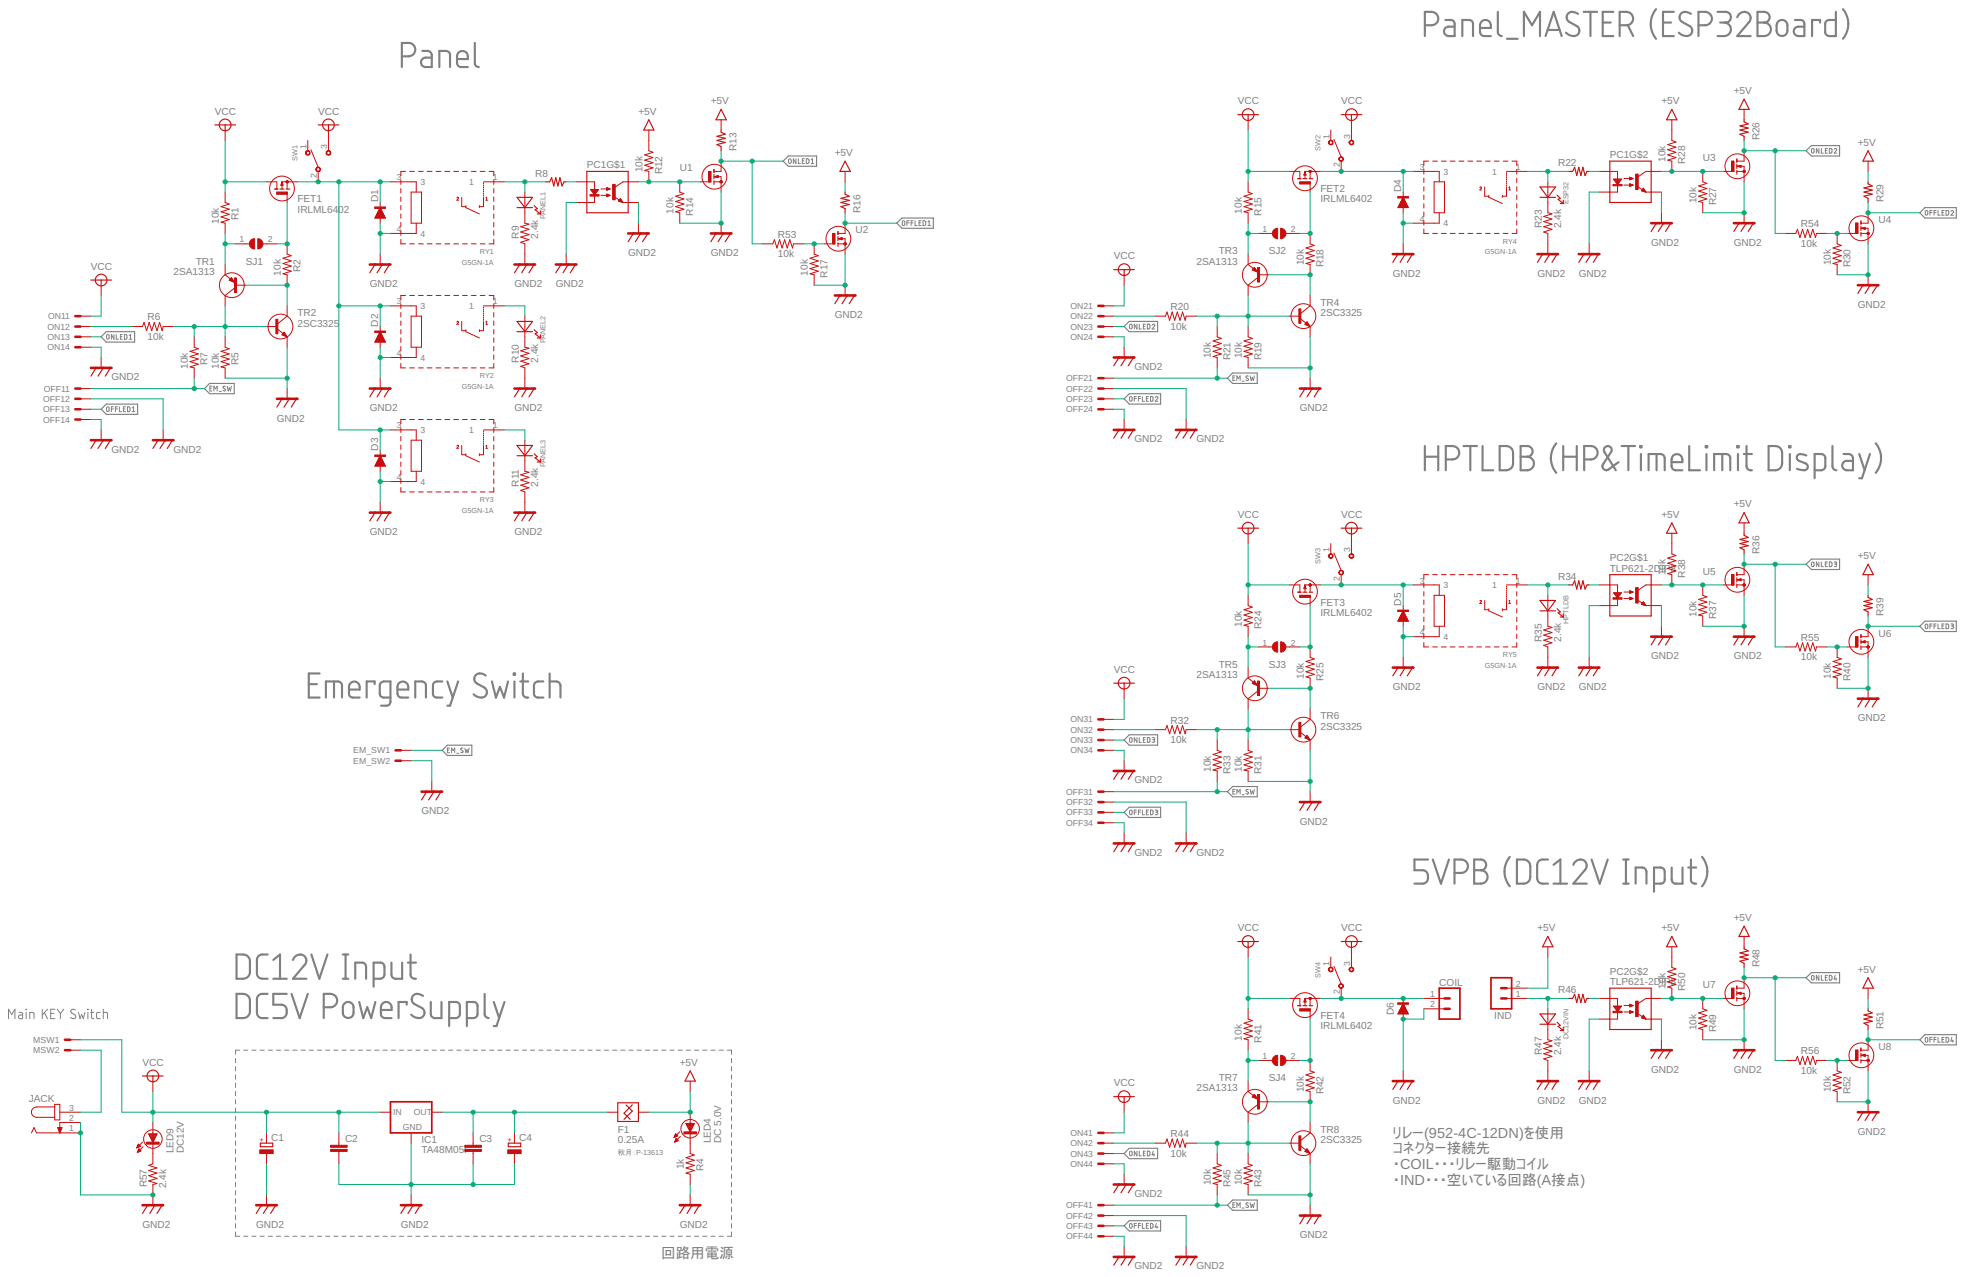
[picture p54: page 1]
