drmus0715/trinitybullet/Hardware/Schematic/5VPB_public.pdf

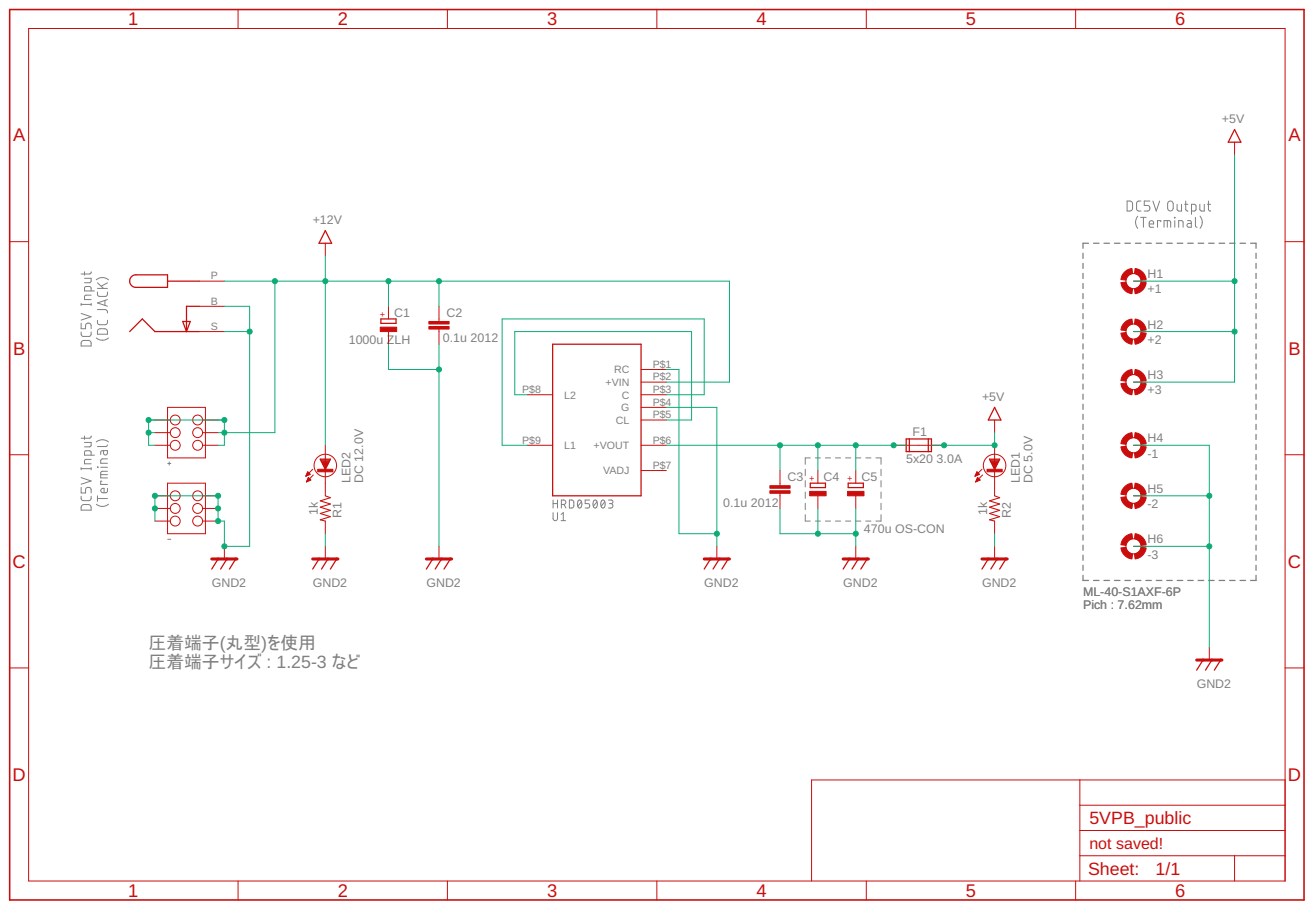
[picture p55: page 1]
