drmus0715/trinitybullet/Hardware/Schematic/HPTLD_MPU_public.pdf

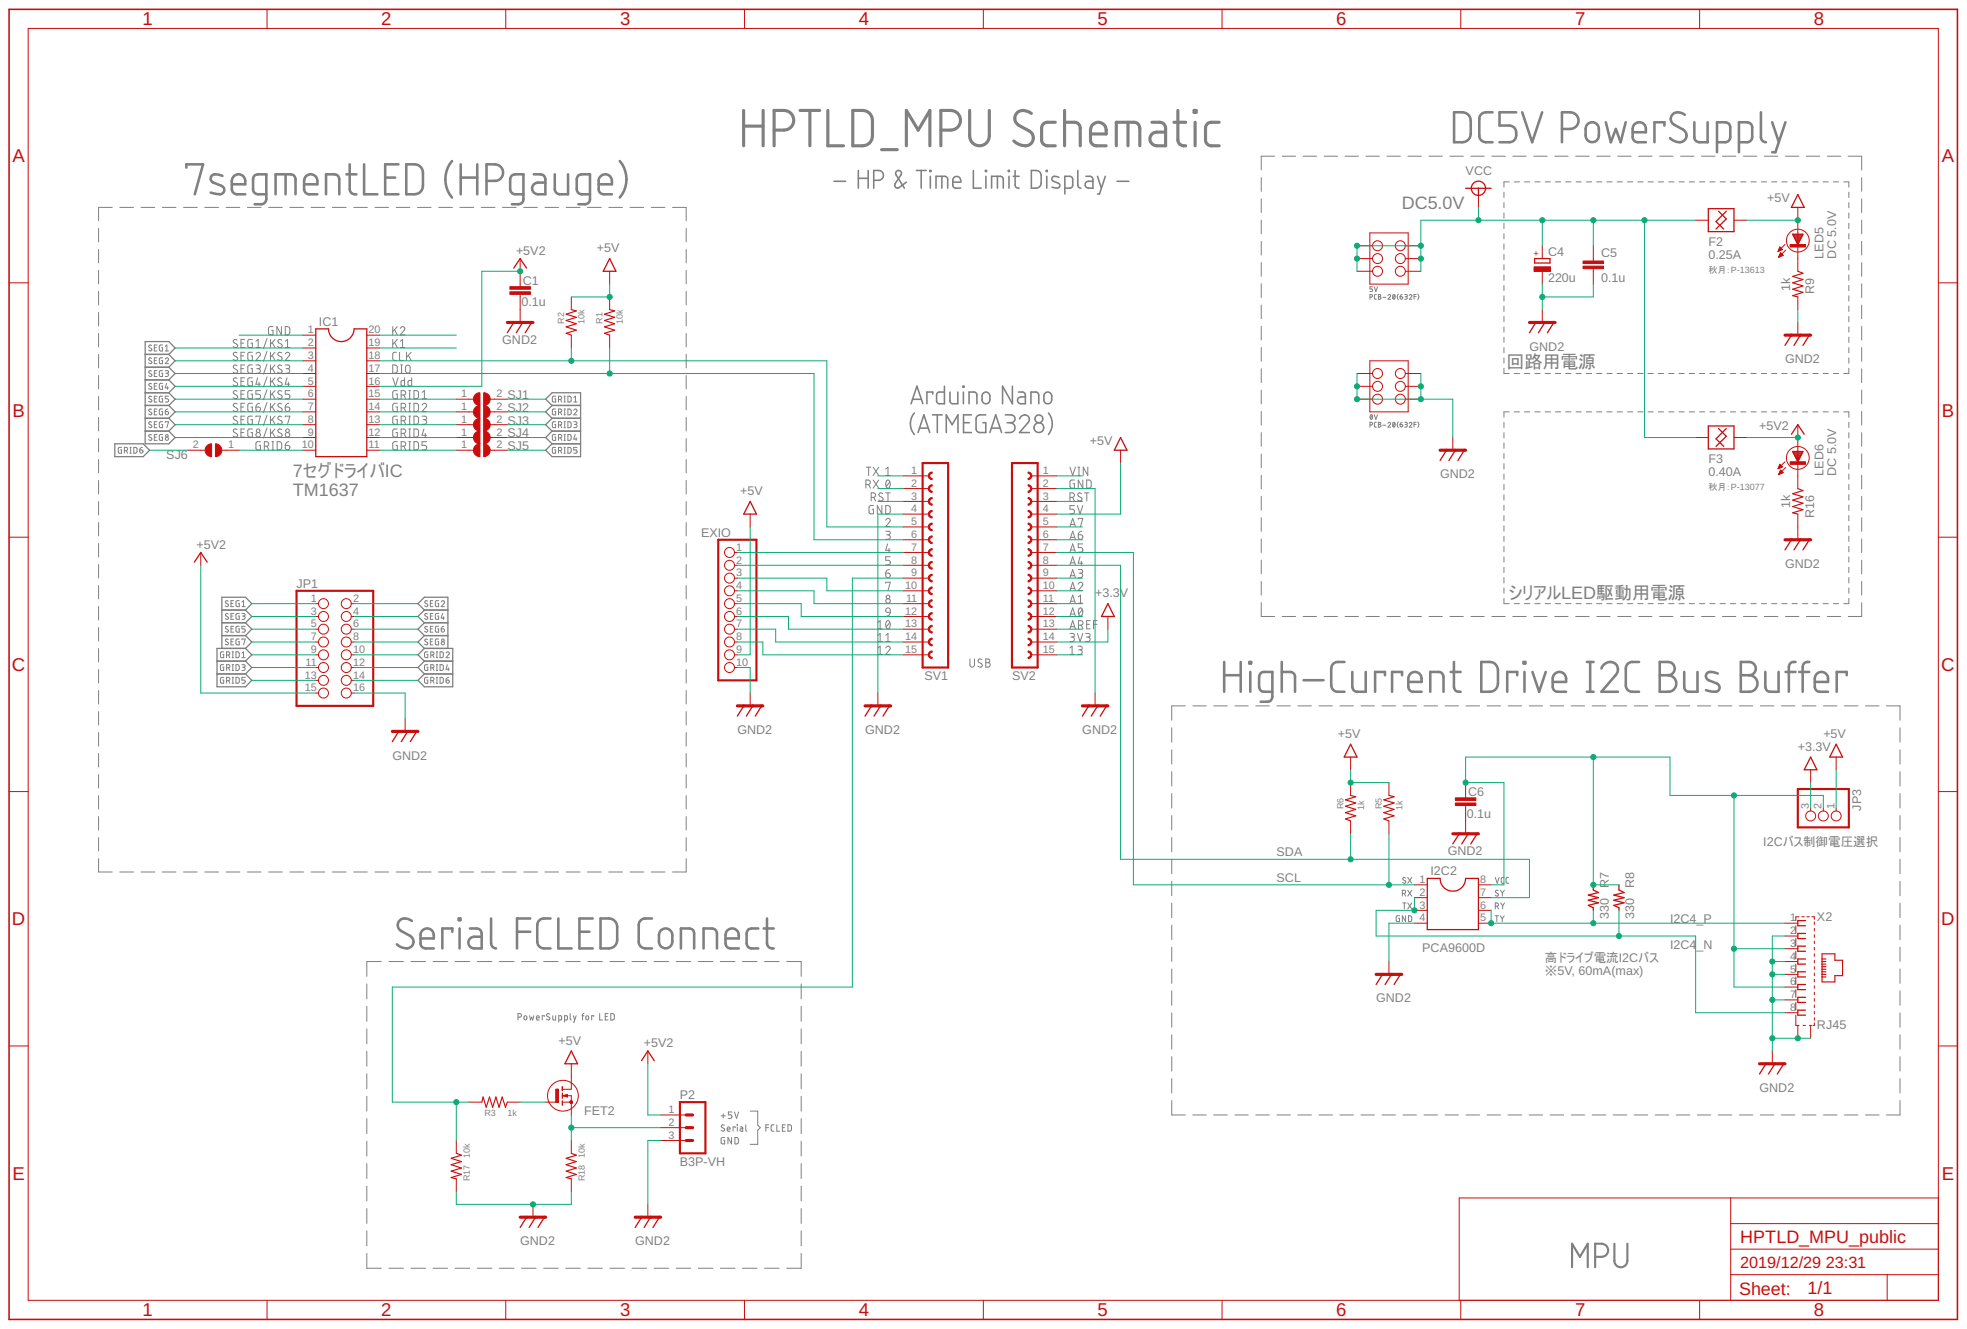
[picture p56: page 1]
