drmus0715/trinitybullet/Hardware/Schematic/HPTLDB_7SEG_public.pdf

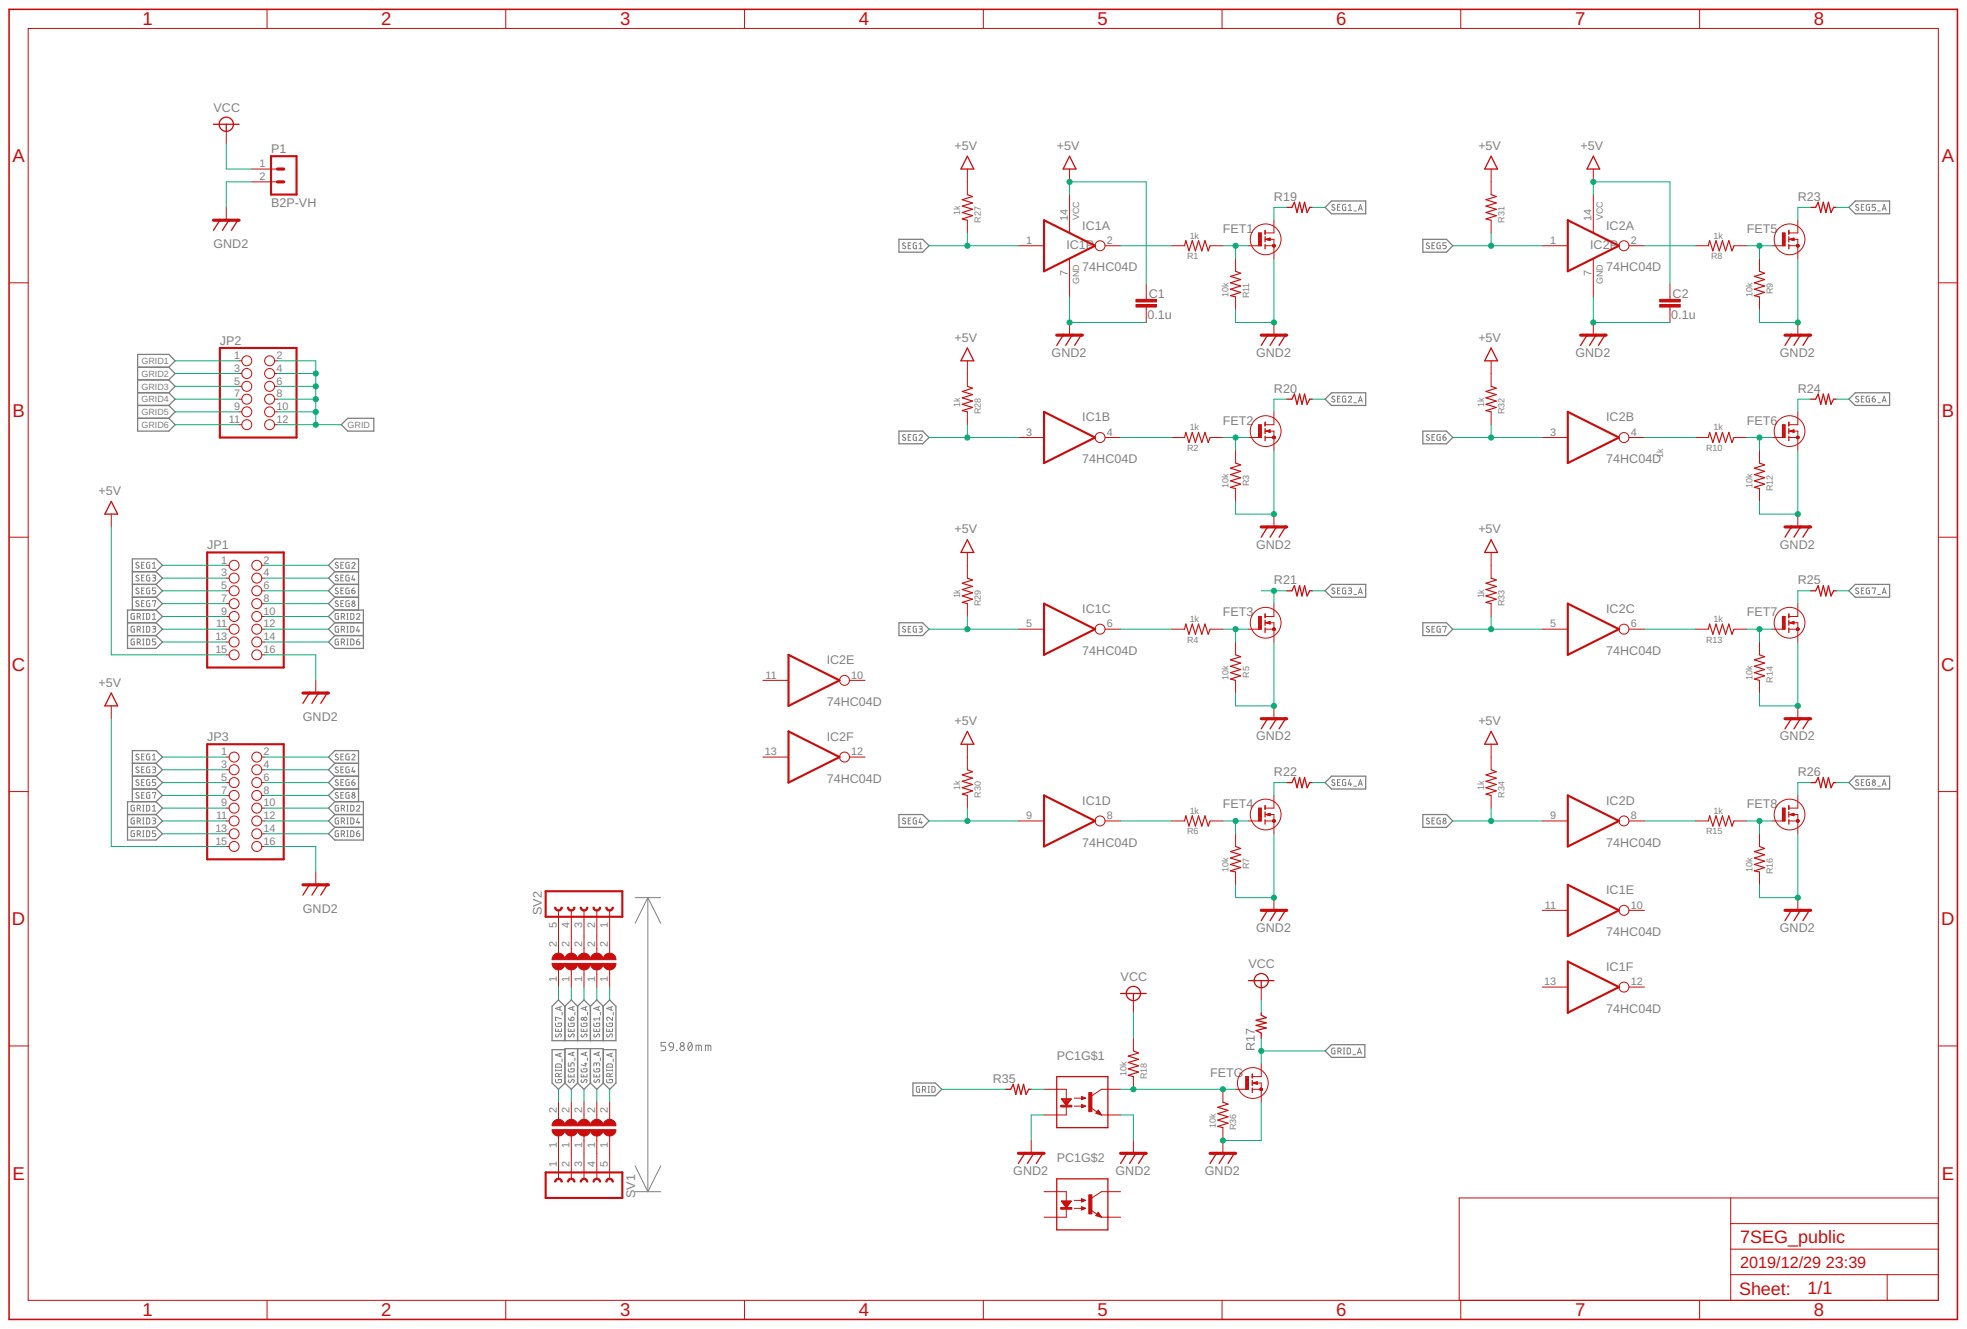
[picture p57: page 1]
