drmus0715/trinitybullet/doc/TirinityBullet_説明用紙_v2.pdf

# ゲームを始める前に

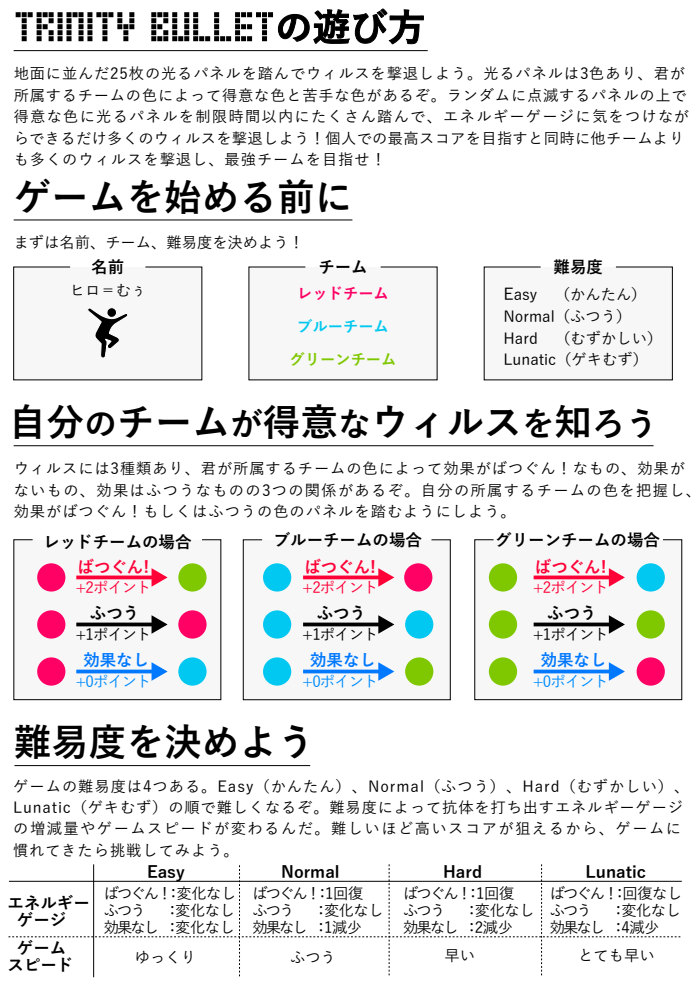
[picture p58: page 1]
⾃分のチームが得意なウィルスを知ろう; 難易度を決めよう; ウィルスには3種類あり、君が所属するチームの⾊によって効果がばつぐん！なもの、効果が ないもの、効果はふつうなものの3つの関係があるぞ。⾃分の所属するチームの⾊を把握し、 効果がばつぐん！もしくはふつうの⾊のパネルを踏むようにしよう。; レッドチーム; ブルーチーム; グリーンチーム; Easy （かんたん） Normal（ふつう） Hard （むずかしい） Lunatic（ゲキむず）; チーム; 難易度; レッドチームの場合; エネルギー ゲージ; ゲーム スピード; ばつぐん！：1回復 ふつう ：変化なし 効果なし ：1減少; ばつぐん！：1回復 ふつう ：変化なし 効果なし ：2減少; ばつぐん！：回復なし ふつう ：変化なし 効果なし ：4減少; ゆっくり; ふつう; とても早い; ブルーチームの場合; グリーンチームの場合; ばつぐん!; 効果なし; +2ポイント; +1ポイント; +0ポイント

地⾯に並んだ25枚の光るパネルを踏んでウィルスを撃退しよう。光るパネルは3⾊あり、君が
所属するチームの⾊によって得意な⾊と苦⼿な⾊があるぞ。ランダムに点滅するパネルの上で
得意な⾊に光るパネルを制限時間以内にたくさん踏んで、エネルギーゲージに気をつけなが
らできるだけ多くのウィルスを撃退しよう！個⼈での最⾼スコアを目指すと同時に他チームより
も多くのウィルスを撃退し、最強チームを目指せ！

まずは名前、チーム、難易度を決めよう！

ゲームの難易度は4つある。Easy（かんたん）、Normal（ふつう）、Hard（むずかしい）、
Lunatic（ゲキむず）の順で難しくなるぞ。難易度によって抗体を打ち出すエネルギーゲージ
の増減量やゲームスピードが変わるんだ。難しいほど⾼いスコアが狙えるから、ゲームに
慣れてきたら挑戦してみよう。

Easy Normal Hard Lunatic
ばつぐん！：変化なし
ふつう ：変化なし
効果なし ：変化なし

# ゲームの流れ

# 名前・チーム

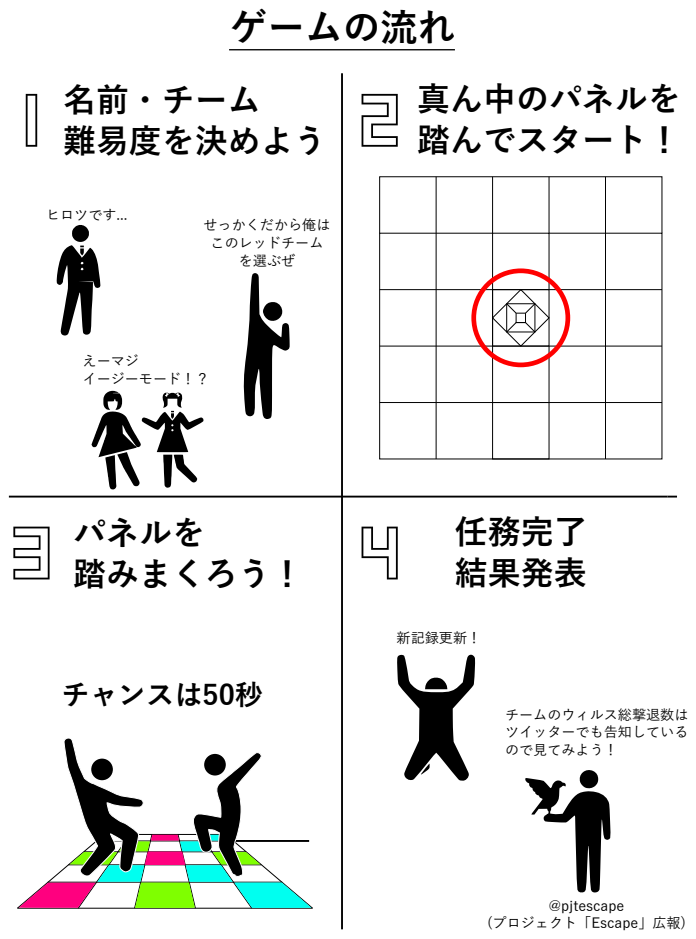
[picture p59: page 2]
チャンスは50秒; 難易度を決めよう; 真ん中のパネルを 踏んでスタート！; パネルを 踏みまくろう！; 任務完了 結果発表; ヒロツです...; せっかくだから俺は; このレッドチーム を選ぶぜ; えーマジ イージーモード！？; 新記録更新！; チームのウィルス総撃退数は ツイッターでも告知している ので⾒てみよう！; @pjtescape

(プロジェクト「Escape」広報)
