drmus0715/trinitybullet/doc/2019 Escプロジェクト「Trinity Bullet」ゲーム仕様書.pdf

## 2019 Esc「Trinity Bullet」

# ゲーム仕様書

2019年6⽉9⽇初版 byひろたけ
以降随時更新

## 1. 概要

本⽂書では、2019年度Escプロジェクト「Trinity Bullet」のゲームの仕様を定めます。

# 2. アトラクション概要

(ひで案より)
プレイ前に⾃分の⾊を決めてもらい、⾃分の⾊と敵の⾊を制限時間内に踏みまくるゲーム。中⽴⾊ を踏んだら⾃チーム減点。
踏んだパネルは消灯し、数秒後ランダムでまた点灯
個⼈でどれだけ踏めるかと、⾊というミニチームで競争する遊び ⼀⽇の結果はSNSを通じて公表

# 3. ストーリー

（検討中）

## 4. 詳細

## 4.1. ゲームの流れ

1. プレイヤーネーム・難易度・加⼊するチームを登録
2. 制限時間まで光るパネルをひたすら踏む
3. プレイリザルトをもらう
4.2. ⾊

⾚チーム・⻘チーム・緑チームのどれかに加⼊
⾚チーム
緑のウイルスに強い、⻘のウイルスに弱い

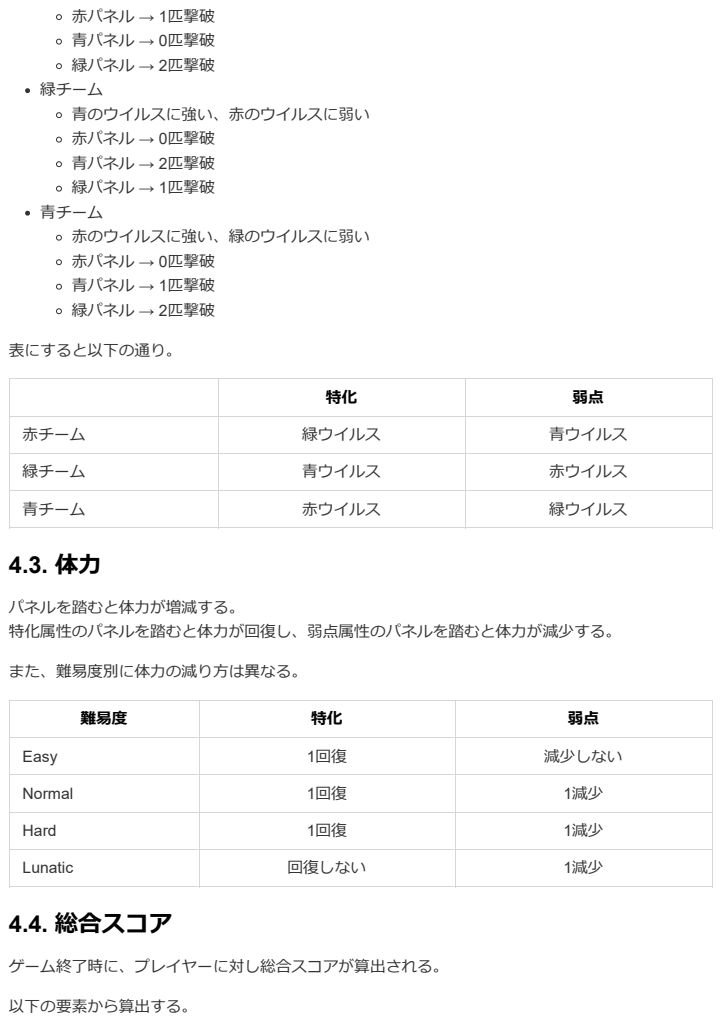
[picture p60: page 2]
⾚パネル → 1匹撃破 ⻘パネル → 0匹撃破 緑パネル → 2匹撃破 緑チーム ⻘のウイルスに強い、⾚のウイルスに弱い ⾚パネル → 0匹撃破 ⻘パネル → 2匹撃破 緑パネル → 1匹撃破 ⻘チーム ⾚のウイルスに強い、緑のウイルスに弱い ⾚パネル → 0匹撃破 ⻘パネル → 1匹撃破 緑パネル → 2匹撃破; 表にすると以下の通り。; 4.4. 総合スコア; ゲーム終了時に、プレイヤーに対し総合スコアが算出される。; 以下の要素から算出する。

⾚チーム | 緑ウイルス | ⻘ウイルス
緑チーム | ⻘ウイルス | ⾚ウイルス
⻘チーム | ⾚ウイルス | 緑ウイルス

パネルを踏むと体⼒が増減する。
特化属性のパネルを踏むと体⼒が回復し、弱点属性のパネルを踏むと体⼒が減少する。
また、難易度別に体⼒の減り⽅は異なる。

難易度 | 特化 | 弱点
Easy | 1回復 | 減少しない

Normal | 1回復 | 1減少

Hard | 1回復 | 1減少

Lunatic | 回復しない | 1減少

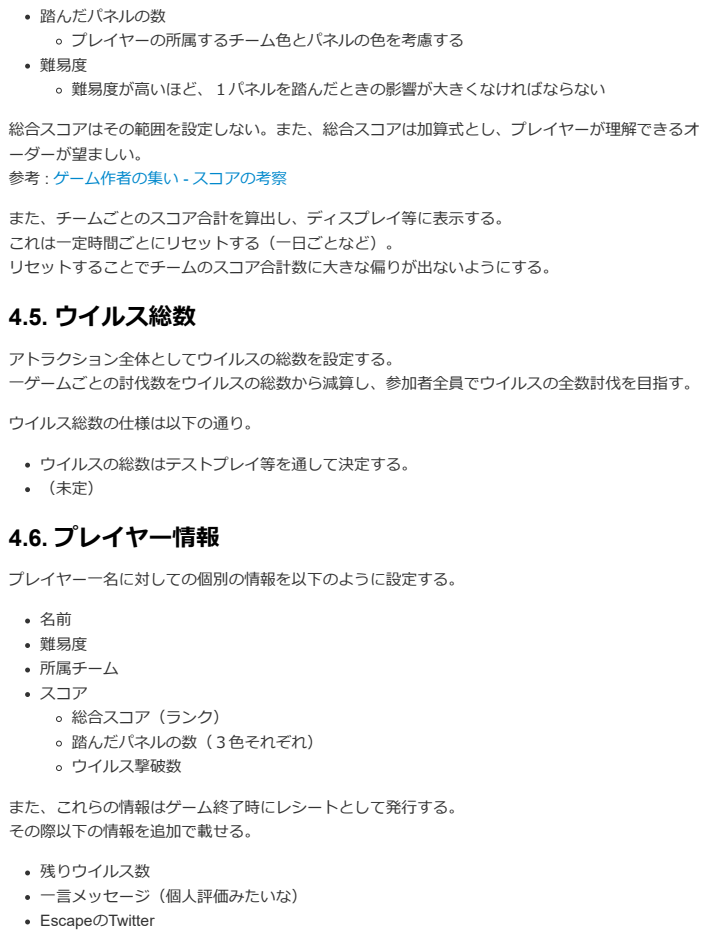
[picture p61: page 3]
アトラクション全体としてウイルスの総数を設定する。 ⼀ゲームごとの討伐数をウイルスの総数から減算し、参加者全員でウイルスの全数討伐を⽬指す。; ウイルス総数の仕様は以下の通り。; ウイルスの総数はテストプレイ等を通して決定する。 （未定） 4.6. プレイヤー情報; プレイヤー⼀名に対しての個別の情報を以下のように設定する。; 名前 難易度 所属チーム スコア 総合スコア（ランク） 踏んだパネルの数（３⾊それぞれ） ウイルス撃破数; また、これらの情報はゲーム終了時にレシートとして発⾏する。 その際以下の情報を追加で載せる。; 残りウイルス数 ⼀⾔メッセージ（個⼈評価みたいな） EscapeのTwitter

踏んだパネルの数
プレイヤーの所属するチーム⾊とパネルの⾊を考慮する
難易度
難易度が⾼いほど、１パネルを踏んだときの影響が⼤きくなければならない
総合スコアはその範囲を設定しない。また、総合スコアは加算式とし、プレイヤーが理解できるオ
ーダーが望ましい。
参考 : ゲーム作者の集い - スコアの考察 (https://www5.atwiki.jp/yaruhara/pages/90.html)
また、チームごとのスコア合計を算出し、ディスプレイ等に表⽰する。
これは⼀定時間ごとにリセットする（⼀⽇ごとなど）。
リセットすることでチームのスコア合計数に⼤きな偏りが出ないようにする。
4.5. ウイルス総数

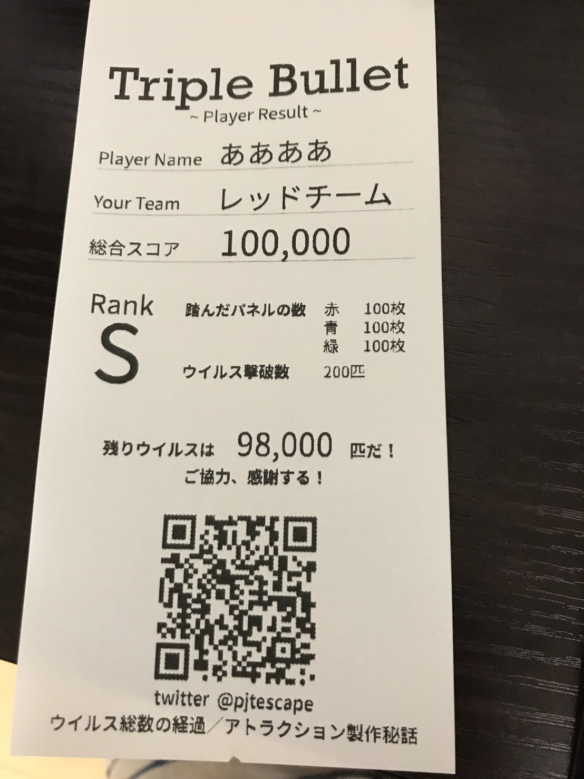
[picture p62: figure]
