drmus0715/trinitybullet/Software/Master_v2/src/ctrl_main.h

/*****************************************************************************/
/**
 * @file filename.h
 * @comments ##
 *
 * MODIFICATION HISTORY:
 *
 * Ver   Who           Date        Changes
 * ----- ------------- ----------- --------------------------------------------
 * x.xx  [user]        2019/xx/xx  First release
 *
 ******************************************************************************/
#ifndef CTRL_MAIN_H
#define CTRL_MAIN_H

#ifdef __cplusplus
extern "C" {
#endif

/*****************************************************************************/
/* Include Files
******************************************************************************/

/*****************************************************************************/
/* Constant Definitions
******************************************************************************/

/*****************************************************************************/
/* TAG Definitions
******************************************************************************/

/*****************************************************************************/
/* Variable Definitions
******************************************************************************/

/*****************************************************************************/
/* Function Prototypes
******************************************************************************/
esp_err_t lInitCtrlMainFunction();
BOOL_t xSendPlayerInfoQueue(playerInfo_t playerInfo);
BOOL_t xSendCtrlCanRxQueue(canCommMsg_t canRxMsg);

#ifdef __cplusplus
}
#endif
#endif
