drmus0715/trinitybullet/Software/Master_v2/src/drv_can.h

/*****************************************************************************/
/**
* @file dev_can.h
* @comments CAN送受信
*
* MODIFICATION HISTORY:
*
* Ver   Who           Date        Changes
* ----- ------------- ----------- --------------------------------------------
* 0.00  drmus0715     2019/08/20  First release
*
******************************************************************************/
#ifndef SRC_DEV_CAN_H
#define SRC_DEV_CAN_H

#ifdef __cplusplus
    extern "C" {
#endif

/*****************************************************************************/
/* Include Files
******************************************************************************/
#include "def_system.h"

/*****************************************************************************/
/* Constant Definitions
******************************************************************************/


/*****************************************************************************/
/* TAG Definitions
******************************************************************************/


/*****************************************************************************/
/* Variable Definitions
******************************************************************************/


/*****************************************************************************/
/* Function Prototypes
******************************************************************************/
// Init
esp_err_t lInitCanFunction();

BOOL_t xSendCanTxQueue(canCommMsg_t canTxMsg);

#ifdef __cplusplus
    }
#endif
#endif
