drmus0715/trinitybullet/Software/Master_v2/src/drv_gamemng.h

/*****************************************************************************/
/**
 * @file drv_gamemng.h
 * @comments GameManagement通信モジュール
 *
 * MODIFICATION HISTORY:
 *
 * Ver   Who           Date        Changes
 * ----- ------------- ----------- --------------------------------------------
 * 0.01  drmus0715     2019/08/31  First release
 *
 ******************************************************************************/
#ifndef SRC_DRV_GAMEMNG_H
#define SRC_DRV_GAMEMNG_H

#ifdef __cplusplus
extern "C"
{
#endif

/*****************************************************************************/
/* Include Files
******************************************************************************/
#include "def_system.h"

    /*****************************************************************************/
    /* Constant Definitions
******************************************************************************/

    /*****************************************************************************/
    /* TAG Definitions
******************************************************************************/
    /* ESP->GM メッセージ種別 */
    enum MSG_TYPE
    {
        GMMSG_FIN_PREPARE = 1,
        GMMSG_GAME_START = 2,
        GMMSG_SCORE = 3,
        GMMSG_ENTRY = 4,
        MAX_GMMSG,
    };

    /*****************************************************************************/
    /* Variable Definitions
******************************************************************************/

    /*****************************************************************************/
    /* Function Prototypes
******************************************************************************/
    esp_err_t lInitGameMng();
    BOOL_t xSendGamemngTxQueue(enum MSG_TYPE eTxMsg);
    BOOL_t xSendHttpPostQueue(struct GAME_INFO sGameInfo);

#ifdef __cplusplus
}
#endif
#endif
