drmus0715/trinitybullet/Software/Master_v2/src/drv_hpdltb.h

/*****************************************************************************/
/**
* @file drv_hpdltb.h
* @comments HPDLTB 通信用モジュール
*
* MODIFICATION HISTORY:
*
* Ver   Who           Date        Changes
* ----- ------------- ----------- --------------------------------------------
* 0.01  drmus0715     2019/10/13  First release
*
******************************************************************************/
#ifndef DRV_HPDLTB_H
#define DRV_HPDLTB_H

#ifdef __cplusplus
extern "C"
{
#endif

    /*****************************************************************************/
    /* Include Files
******************************************************************************/

    /*****************************************************************************/
    /* Constant Definitions
******************************************************************************/

    /*****************************************************************************/
    /* TAG Definitions
******************************************************************************/
    /* 
 * HPDLTB 構造体定義
 */

    enum HPDLTB_MSG
    {
        HPDLTB_NORMAL = 0,
        HPDLTB_COUNT,
        HPDLTB_FINISH,
        HPDLTB_BLANK,
        MAX_HPDLTB
    };
    typedef struct HPDLTB
    {
        enum HPDLTB_MSG eMsg;
        uint8_t bHp;
        uint8_t bTimeH;
        uint8_t bTimeL;
    } hpdltb_t;

    /*****************************************************************************/
    /* Variable Definitions
******************************************************************************/

    /*****************************************************************************/
    /* Function Prototypes
******************************************************************************/
    esp_err_t lInitHpdltb();
    BOOL_t xSendHpdltbQueue(hpdltb_t hptldbMsg);

#ifdef __cplusplus
}
#endif
#endif
