drmus0715/trinitybullet/(commit log)

2019-12-29 add : schematic
2019-12-29 Add 説明用紙
2019-12-29 いろいろ
2019-12-29 pixcelは間違いでした
